gelimorto2/binbot/cad/out/E-01_power.pdf

## BINBOT — autonomous olive bin carrier

## POWER — TOP MODULE FED FROM THE BASE

### DWG E-01 REV C BP-04 electronics

PRELIMINARY — check against vendor datasheets 2026-10-28

BASE — bought, NOT modified (vendor)

base battery
+ BMS

base main
switch

MC-L / MC-R
motor controllers
motors + spring brakes
RC receiver
E-stop / enable input
(all vendor)

aux tap at the base battery (vendor terminal / ring lug) F1 40 A
(at the tap)

S1 key
isolator 50 A

K1 lift contactor
50 A, 24 V coil (E-02)

F4 40 A
U3 DC/DC
36-75 → 24 V 25 A
LIFT

Lift H-bridge K7/K8
(MCU) → actuators
M3, M4 + limits

F5 20 A
AUX 4 mm²

F6 10 A
U1 DC/DC
36-75 → 24 V 10 A
CONTROL

+24 V CTRL → F10…F16: computer, LiDAR, cameras, GNSS, MCU, safety relay, display

F8 5 A
U2 DC/DC
36-75 → 12 V 5 A
COMMS

+12 V → 4G router, LoRa, beacon, buzzer

drive commands (E-03)

E-stop / enable (E-02)

DRIVE INTERFACE — nothing on the base is changed:
- CAN or RS485 to the base controllers, if the base has it; otherwise
- the MCU imitates the RC receiver (PWM / SBUS) through changeover relay K9. The handheld remote always has priority (manual mode).
- The safety relay (E-02) opens the base's own E-stop / enable input.

NOTES
1. Base battery voltage assumed 48 V (check). DC/DCs 36-75 V in; for a 60/72 V base use 40-160 V input types.
2. Our load: ≈ 50-120 W continuous + lift 480 W for ~20 s per swap: small next to the base battery.
3. E-stop: K1 drops (lift stops) and the base's E-stop input opens (motors stop, base brakes clamp).
4. Computer, sensors and radio stay powered after an E-stop so the robot can report.
5. Charging: with the base's own charger and socket (vendor).
