gelimorto2/binbot/cad/out/E-04_ebox_layout.pdf

## E-BOX BACKPLATE 460×460 mm (enclosure 500×500×200 IP65, rear of the top module)

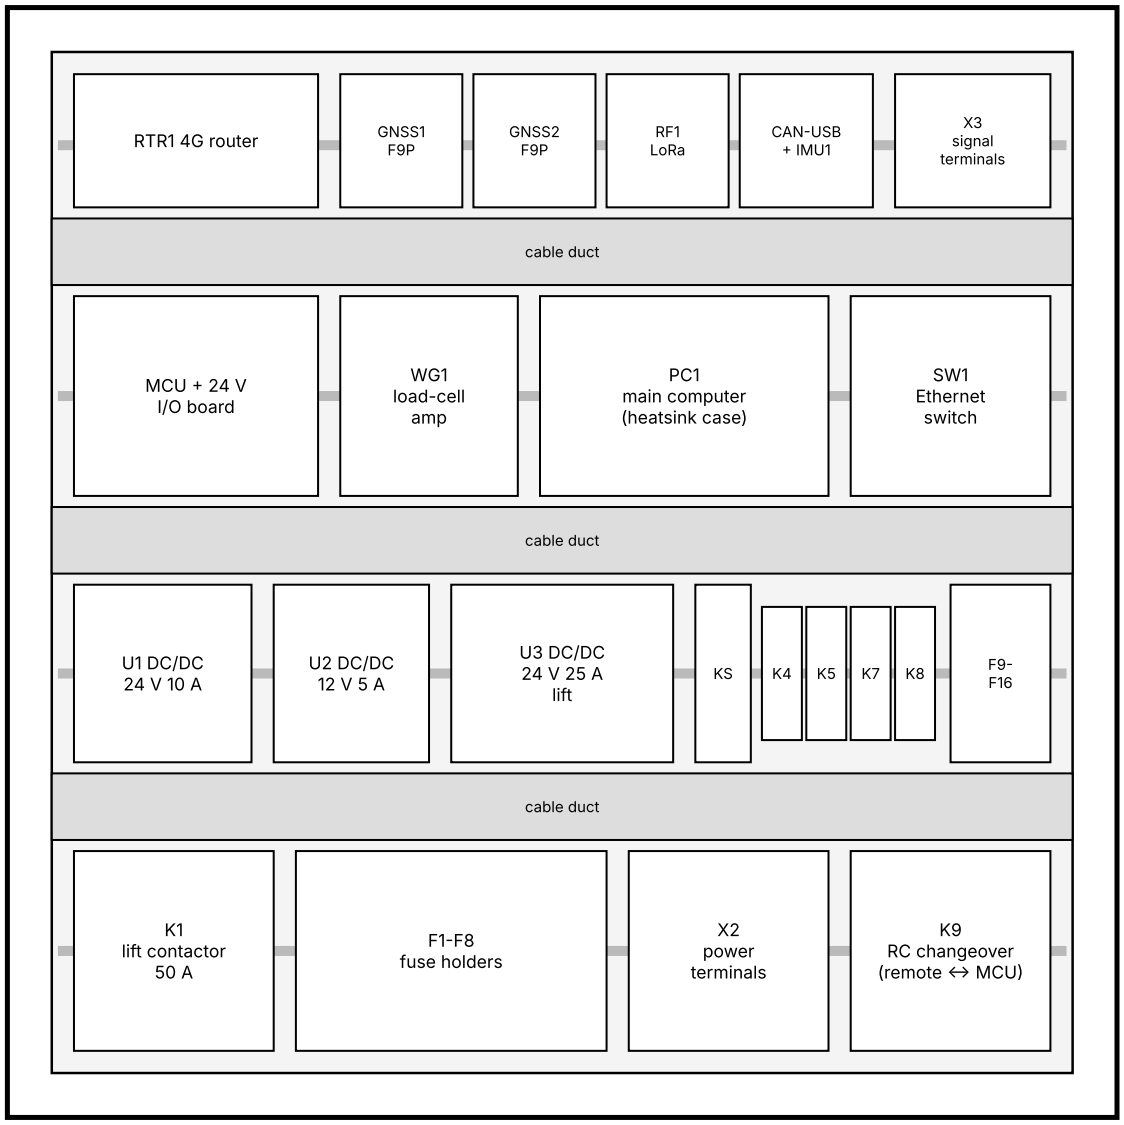
[picture p7: figure]
cable duct; K1 lift contactor 50 A; fuse holders; X2 power terminals; K9 RC changeover (remote ↔ MCU); U3 DC/DC 24 V 25 A lift; MCU + 24 V I/O board; WG1 load-cell amp; PC1 main computer (heatsink case); SW1 Ethernet switch; RTR1 4G router; GNSS1; GNSS2 F9P; RF1 LoRa; CAN-USB; + IMU1; X3 signal terminals

BOTTOM FACE (all cables enter from below, drip loop):

- X10 base drive interface (CAN / RS485 or RC lead) | • X11 base E-stop / enable loop (2 ch)
- X12 power tap from base battery (2 × 6 mm²) | • X13 lift M3/M4 + limits S5/S6
- X14 load cells LC1-LC4 (4× M12) | • X15 front bar: LiDAR, CAM-F, ES1/ES2, edge BF
- X16 rear: ES3/ES4, CAM-R, HMI1, beacon, BR, GNSS1/2 | • nothing goes into the base except X10-X12

RIGHT SIDE: S1 key isolator for the top module
LEFT SIDE: IP65 breather vent + filter fan (thermostat 40 °C) DOOR: nothing mounted (keeps it sealed)

BUILD NOTES
- motor controllers stay in the base (vendor)
- power wiring kept in row A, signals rows C/D
- CAN and Ethernet away from motor cables
- label every wire both ends with its number
- all connectors IP67: Deutsch DT (signals), M12 (sensors/CAN/ETH), Anderson (power)

BINBOT — autonomous olive bin carrier

E-BOX LAYOUT (front view, door open)

DWG E-04 REV C SCALE ≈ 1:4 mm

PRELIMINARY 2026-10-28
