gelimorto2/binbot/cad/out/DWG-001_general_arrangement.png

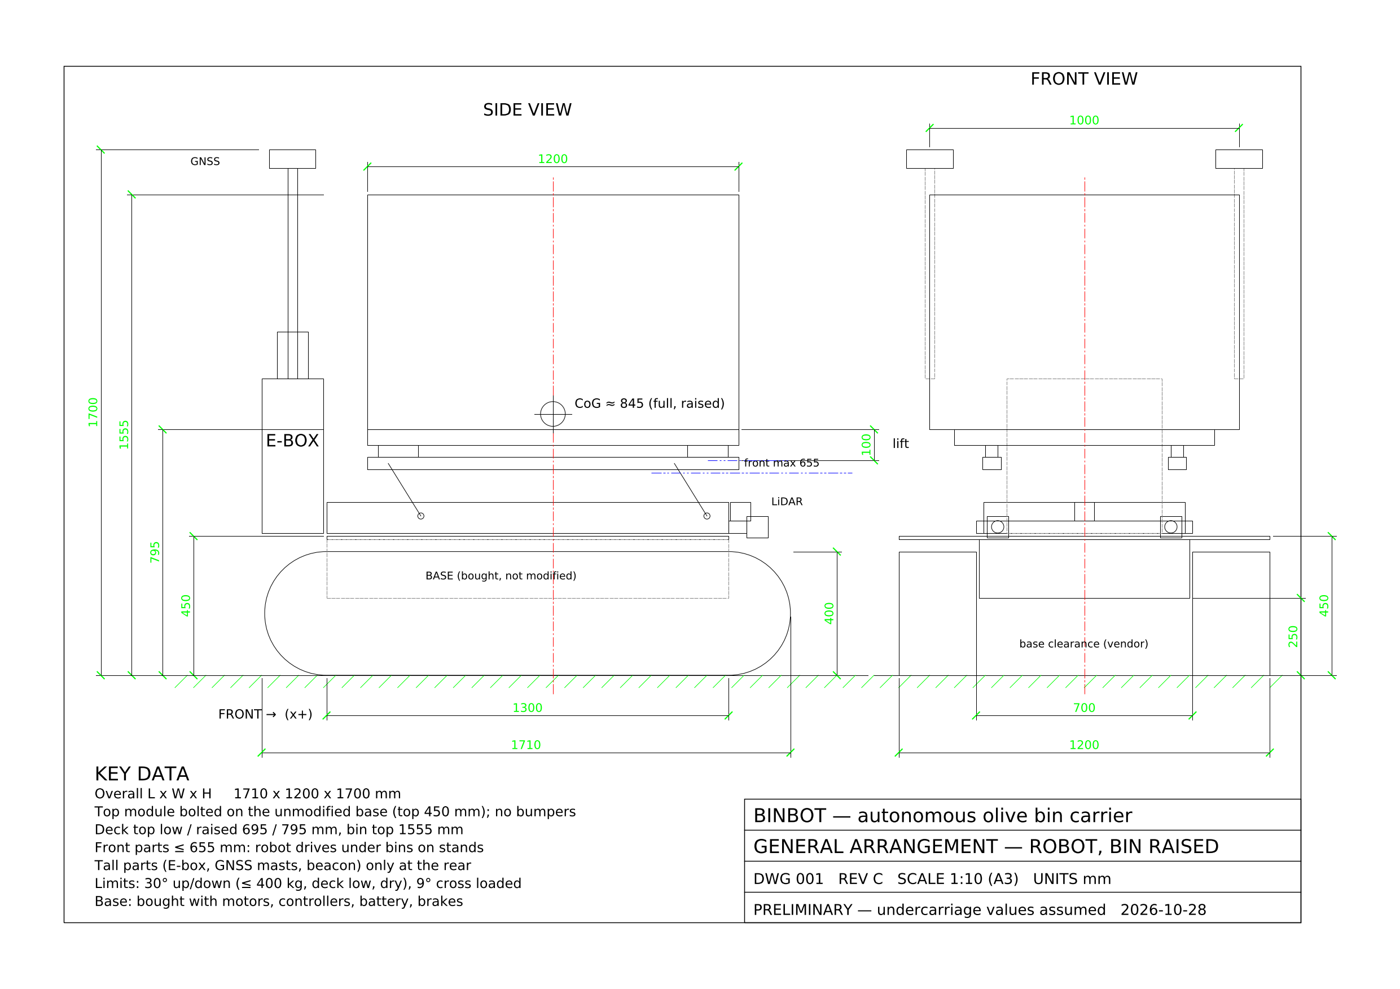
cad/out/DWG-001_general_arrangement.png
