gelimorto2/binbot/cad/out/DWG-002_upper_frame_weldment.png

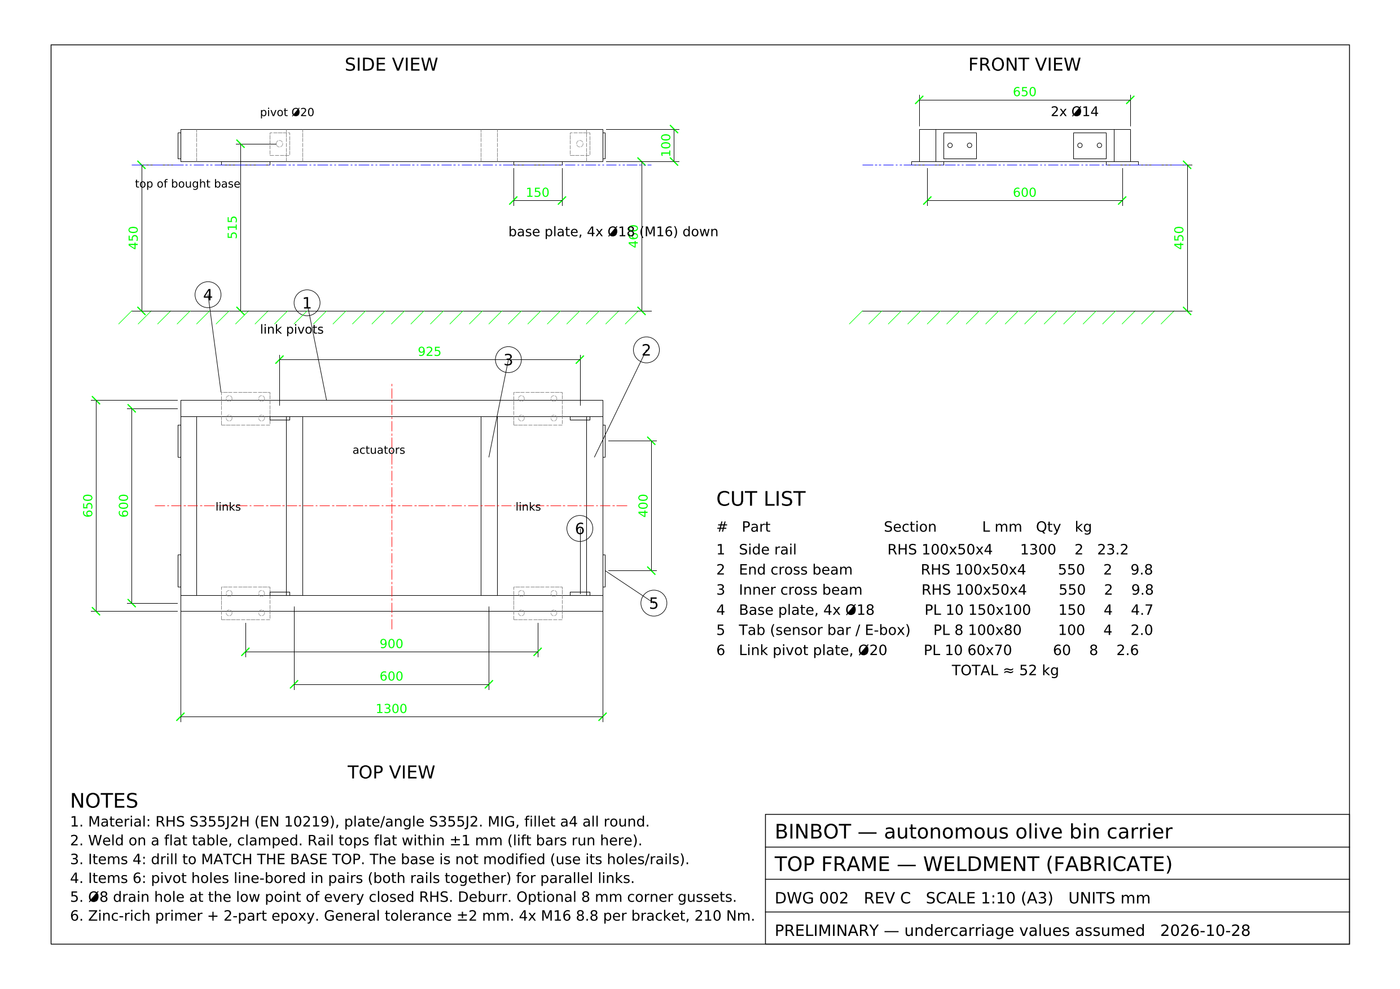
cad/out/DWG-002_upper_frame_weldment.png
