gelimorto2/binbot/cad/out/DWG-003_bin_stand.png

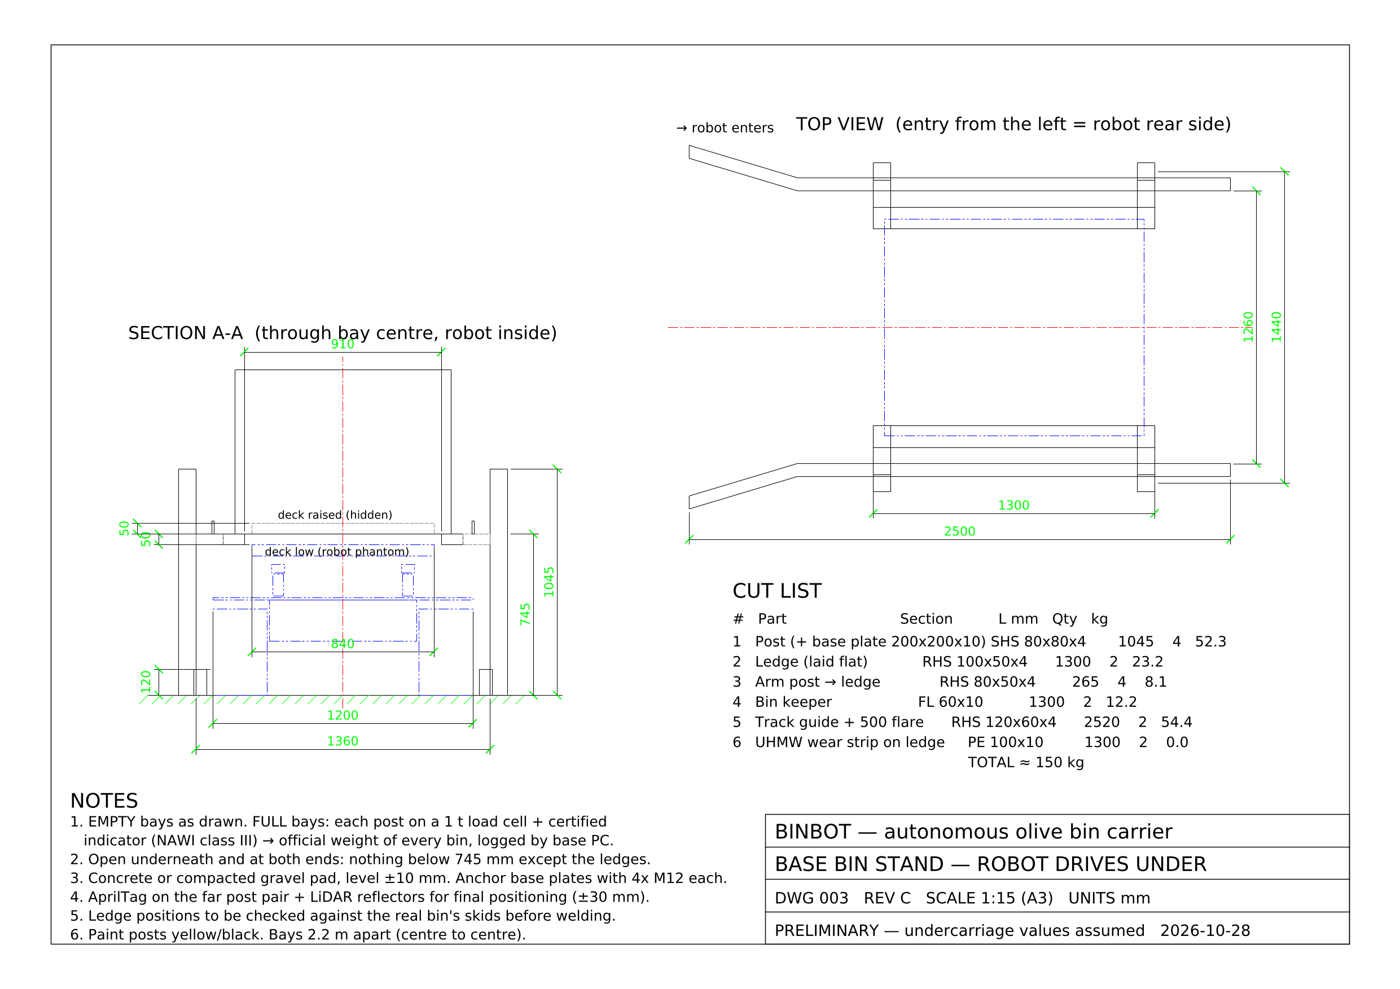
cad/out/DWG-003_bin_stand.png
