gelimorto2/binbot/cad/out/DWG-004_stability.png

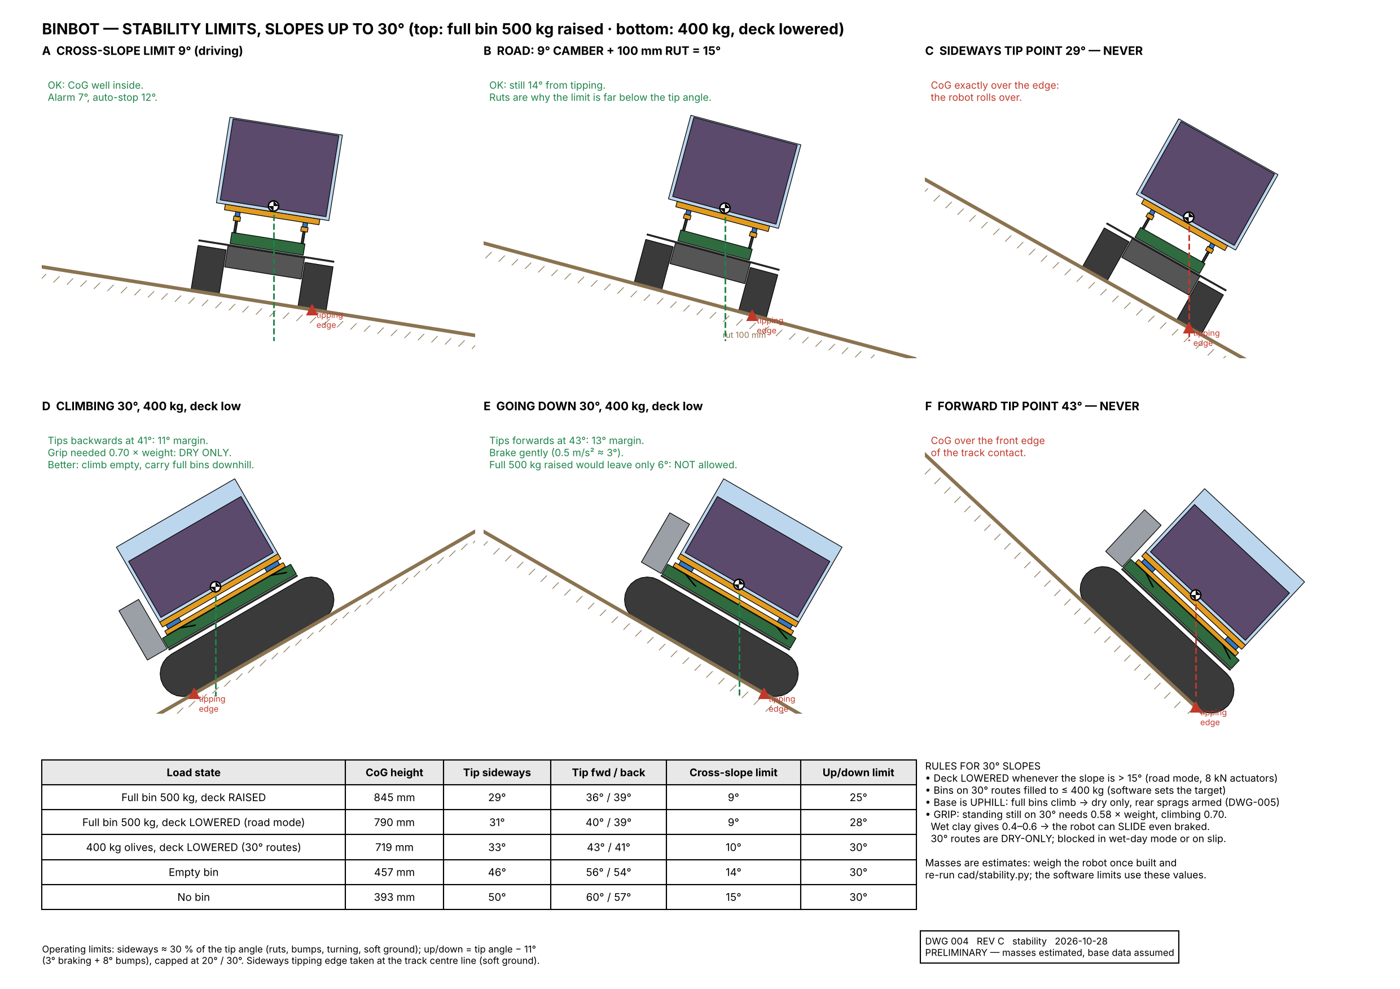
cad/out/DWG-004_stability.png
