gelimorto2/binbot/cad/out/DWG-005_anti_slide.png

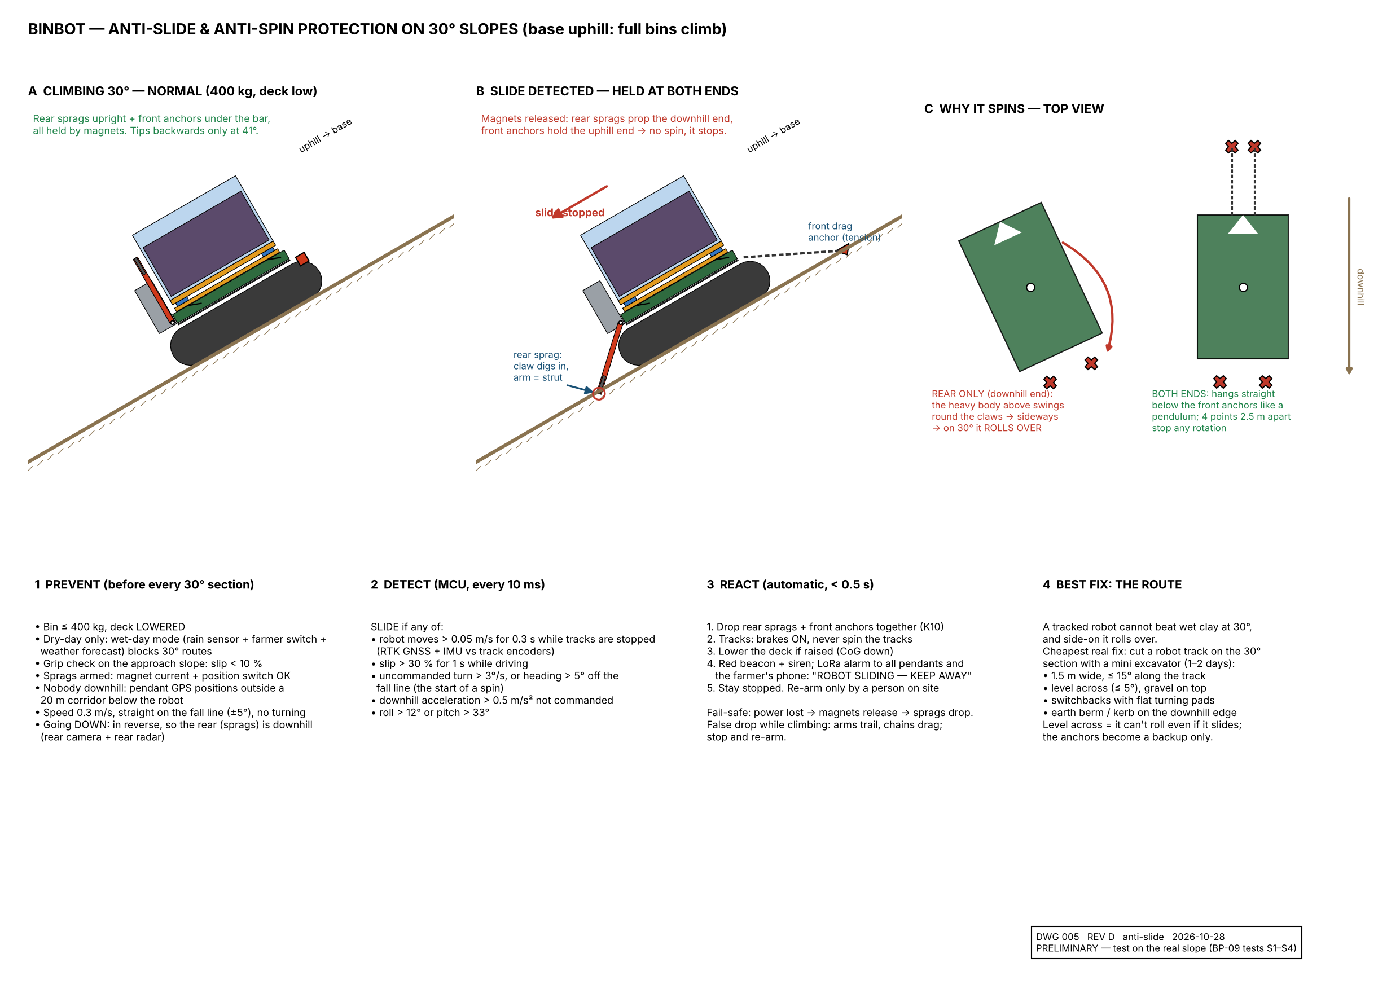
cad/out/DWG-005_anti_slide.png
