gelimorto2/binbot/cad/out/E-01_power.png

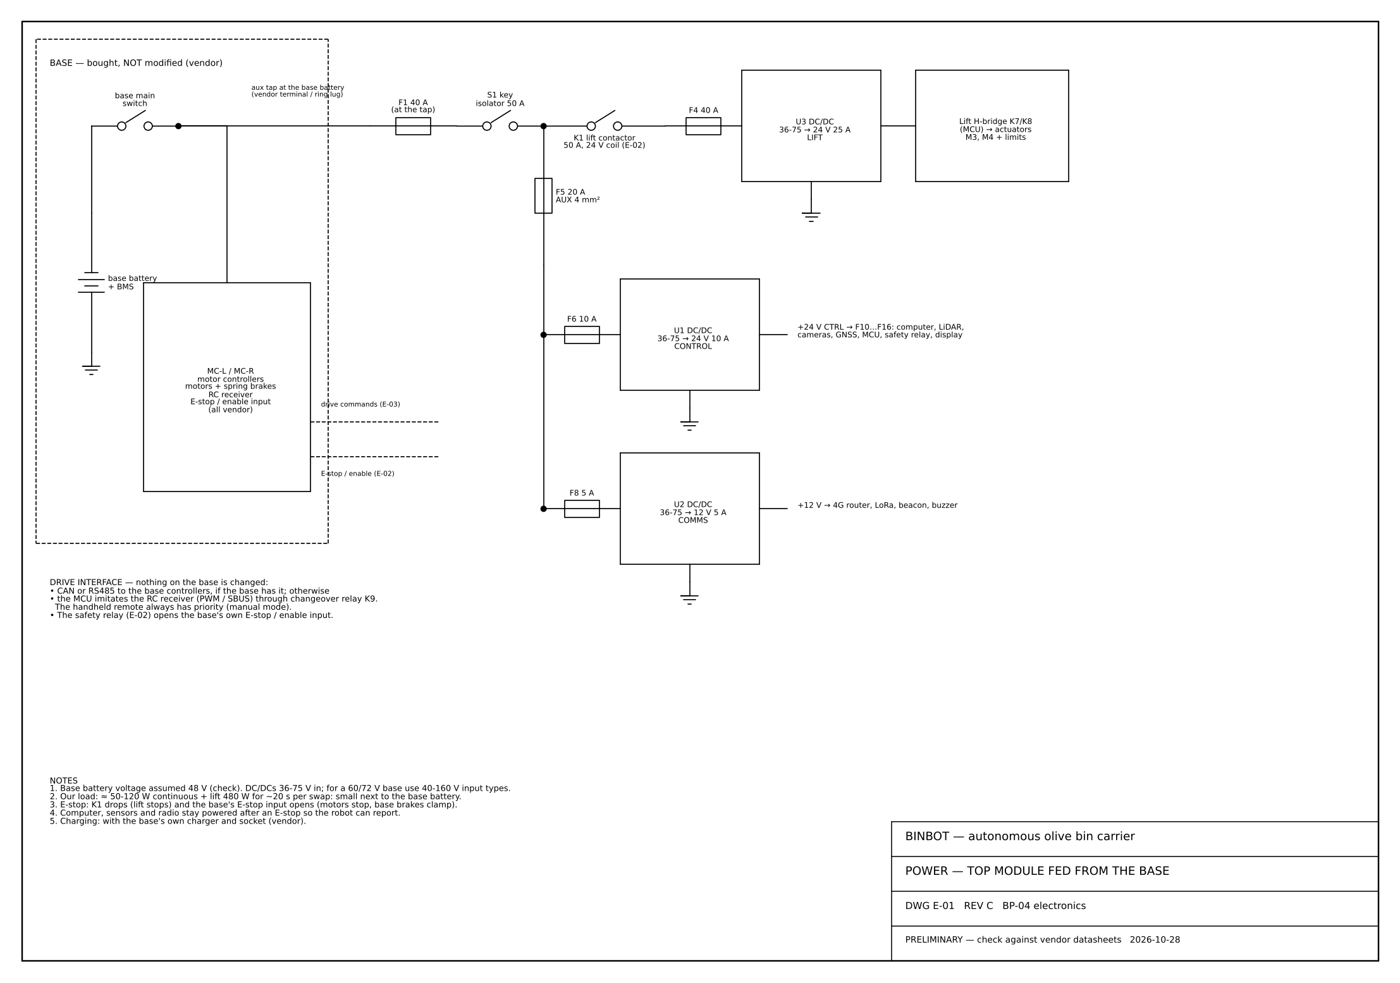
cad/out/E-01_power.png
