gelimorto2/binbot/cad/out/E-02_safety_circuit.png

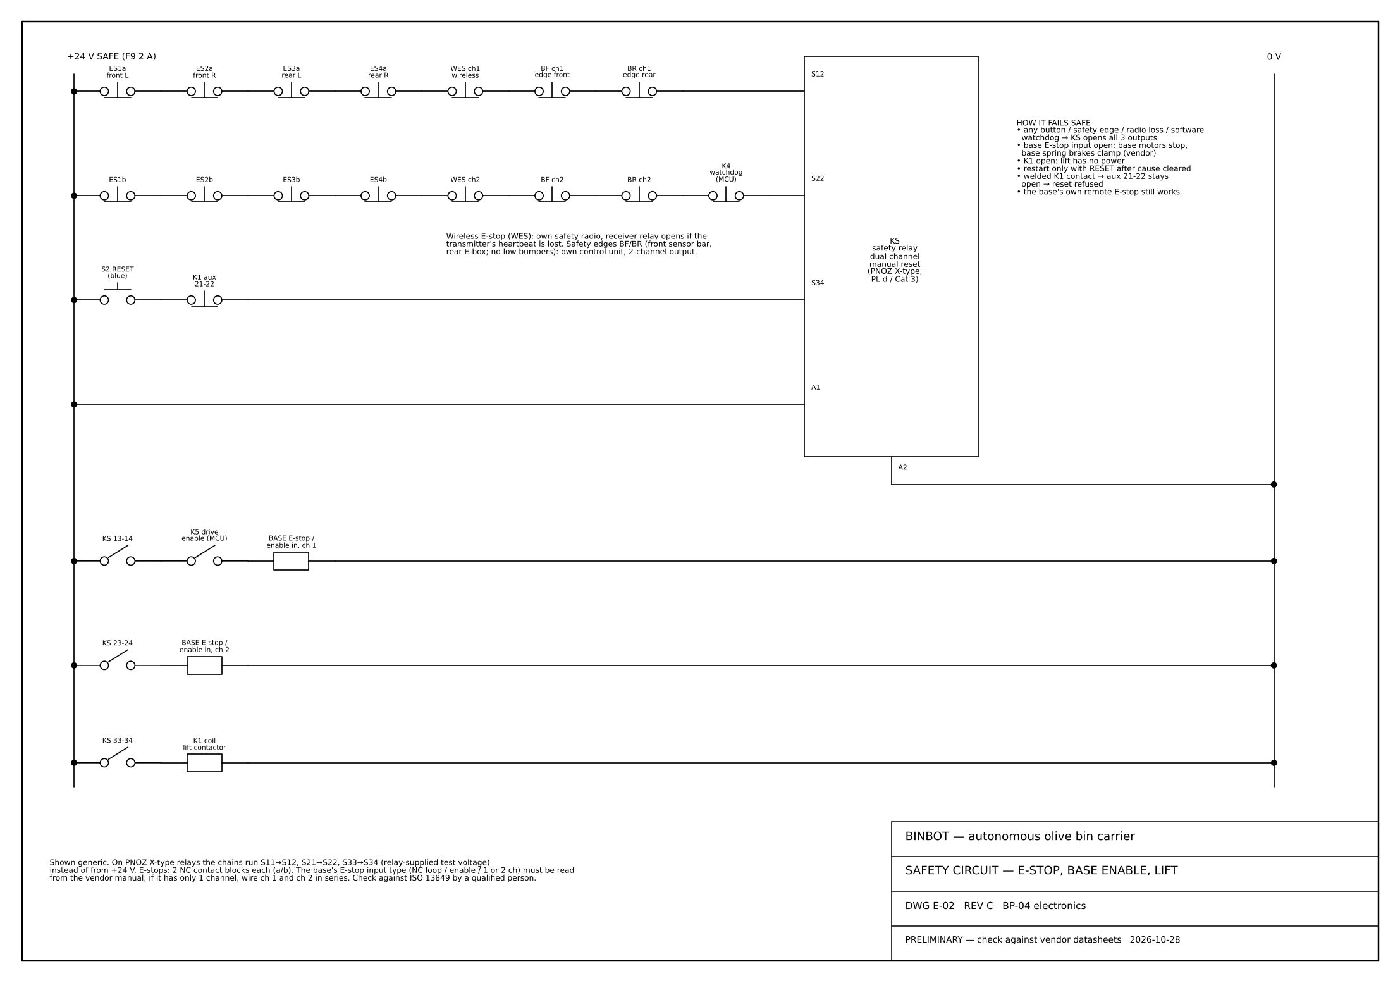
cad/out/E-02_safety_circuit.png
