gelimorto2/binbot/cad/out/E-03_control_block.png

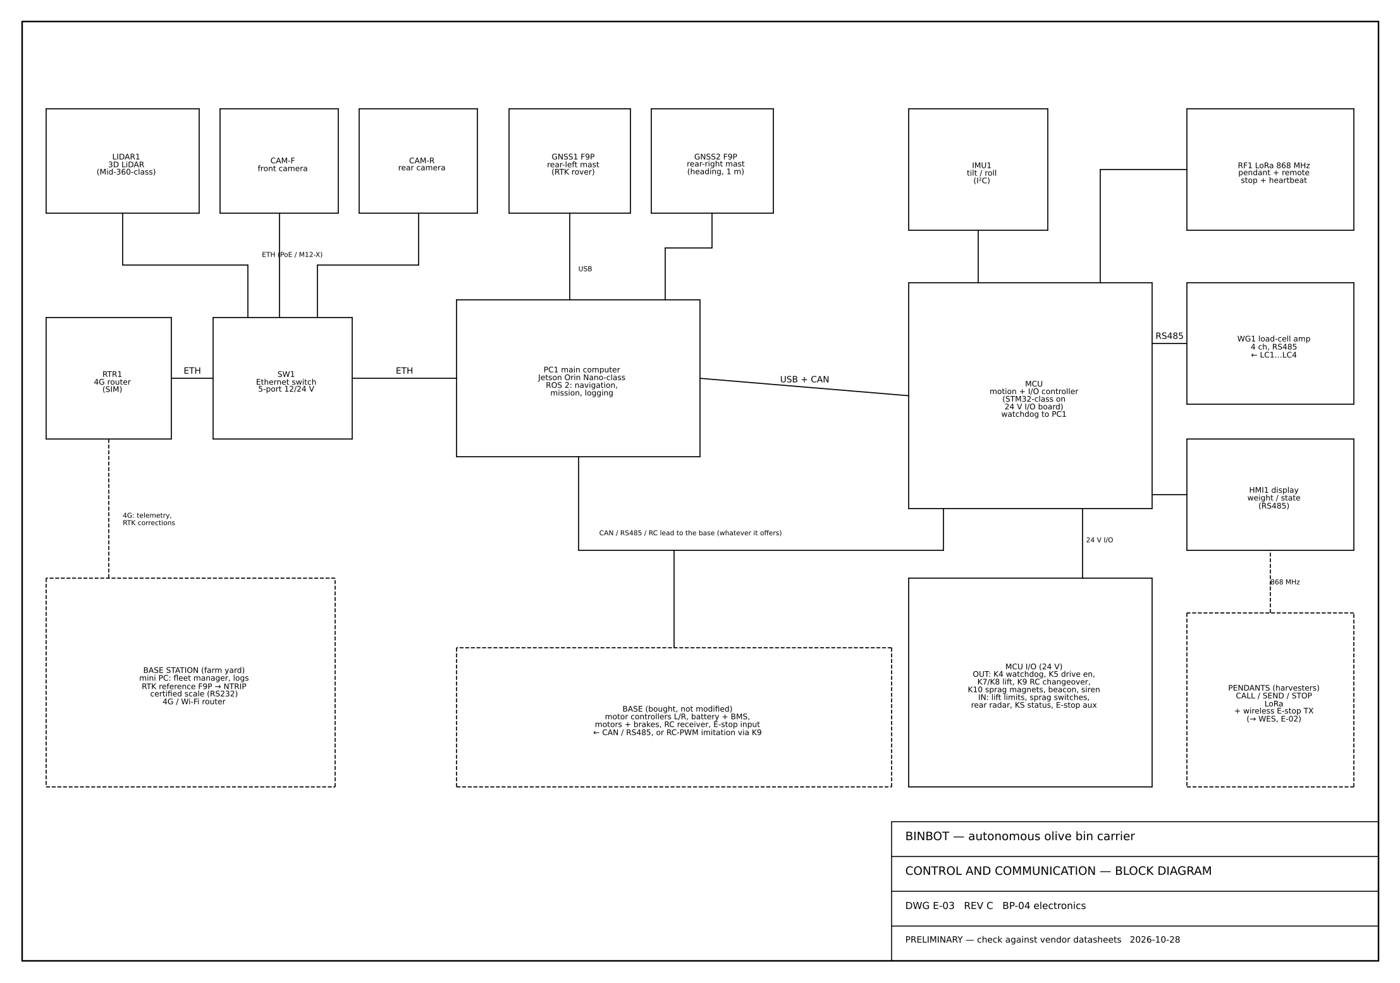
cad/out/E-03_control_block.png
