gelimorto2/binbot/cad/out/E-04_ebox_layout.png

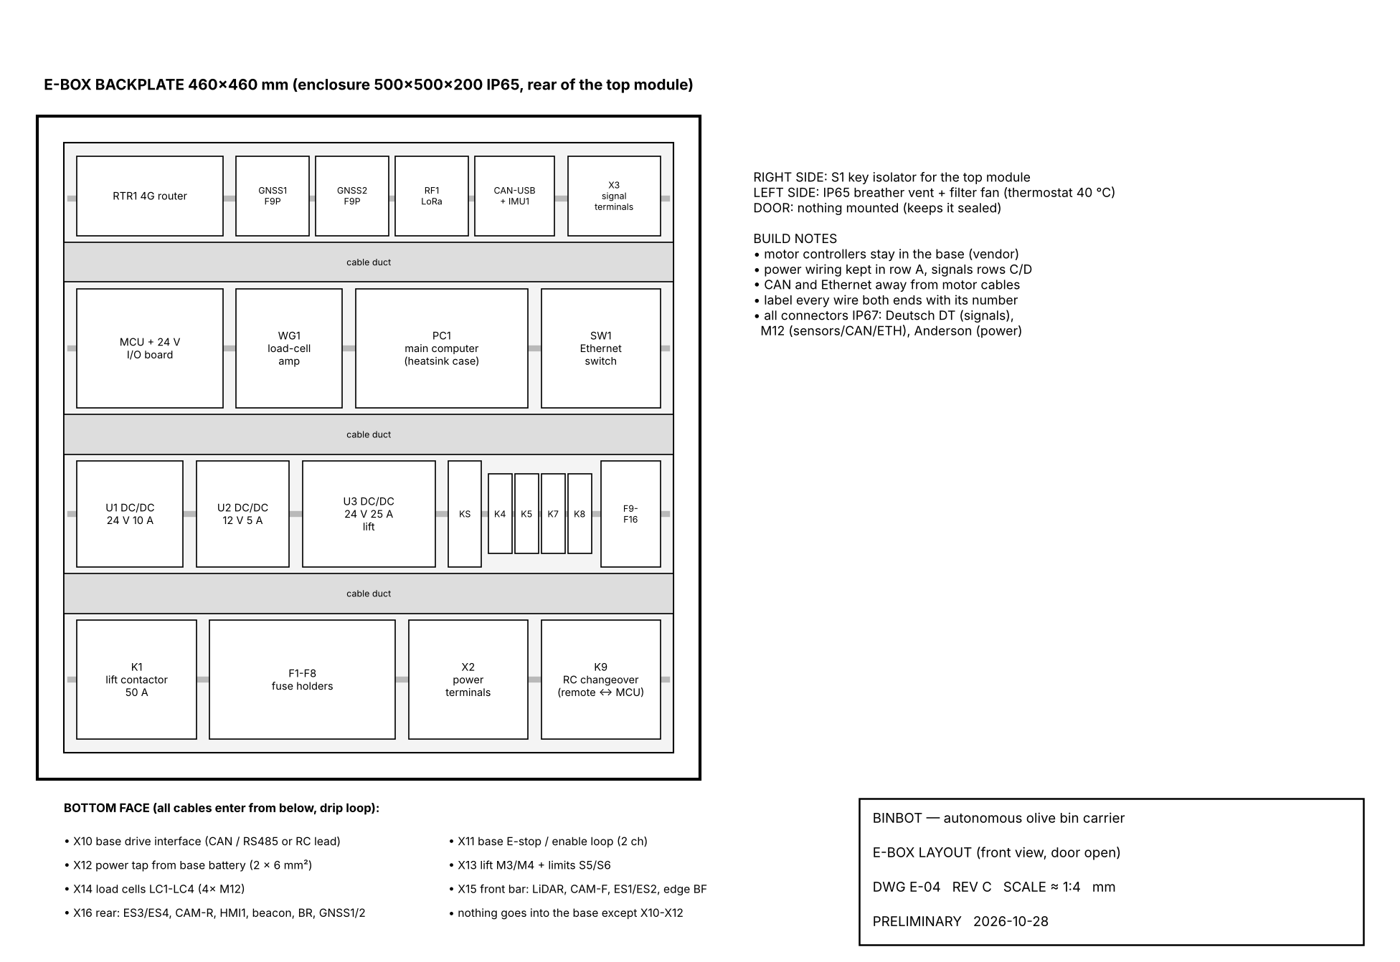
cad/out/E-04_ebox_layout.png
