gelimorto2/binbot/cad/out/chassis_assembly.step

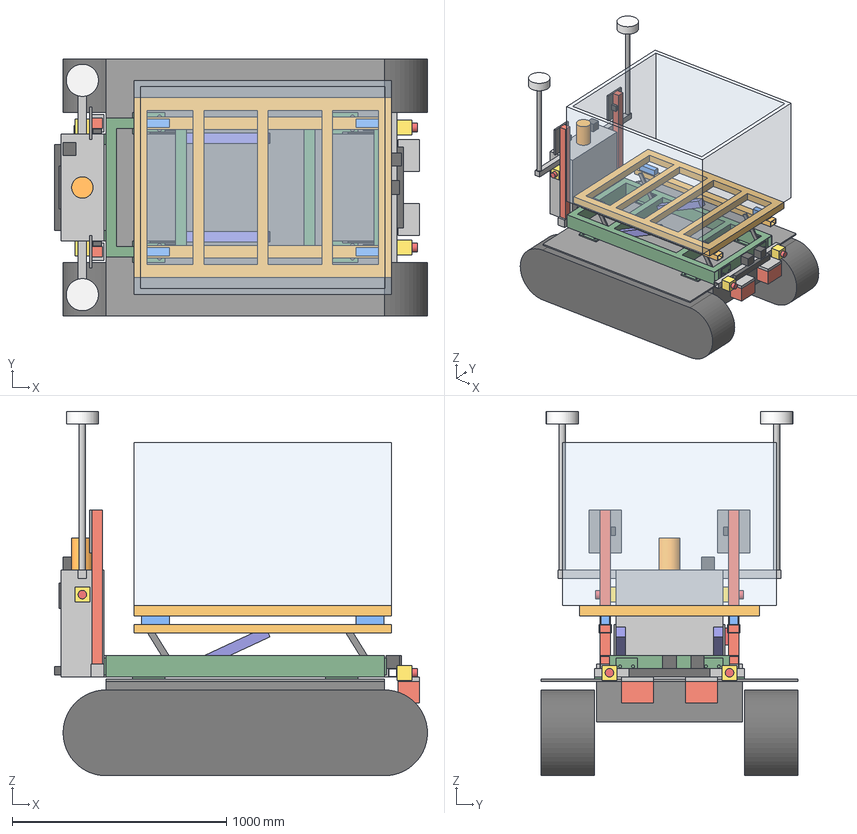
[picture p17: CAD file, 2026-10-28]
cad/out/chassis_assembly.step
1740.0 x 1200.0 x 1700.0 mm
track_L
track_R
base_body
base_top_plate
upper_frame
lift_bar_0
link_1
link_2
lift_actuator_3
load_cell_4
load_cell_5
lift_bar_6
link_7
link_8
lift_actuator_9
load_cell_10
load_cell_11
deck_12
ebox_13
ebox_mount_14
display_15
isolator_S1_16
safety_edge_rear_17
estop_rear_18
estop_rear_knob_19
mast_arm_20
mast_21
gnss_antenna_22
estop_rear_23
estop_rear_knob_24
mast_arm_25
mast_26
gnss_antenna_27
beacon_28
sprag_arm_29
sprag_claw_30
sprag_pivot_31
sprag_magnet_32
sprag_arm_33
sprag_claw_34
sprag_pivot_35
sprag_magnet_36
cam_rear_37
front_bar_38
front_bar_arm_39
estop_front_40
estop_front_knob_41
front_bar_arm_42
estop_front_43
estop_front_knob_44
lidar_45
drag_anchor_46
anchor_holder_47
drag_anchor_48
anchor_holder_49
cam_front_50
safety_edge_front_51
bin
