gelimorto2/binbot/cad/out/upper_frame.step

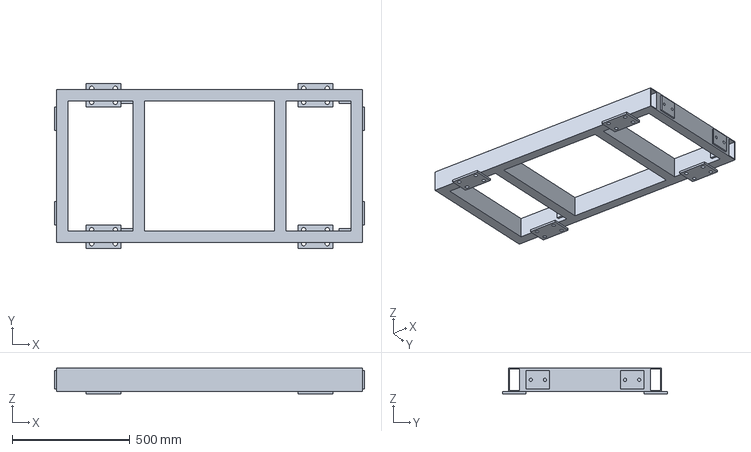
[picture p18: CAD file, 2026-10-28]
cad/out/upper_frame.step
1316.0 x 700.0 x 110.0 mm
