gelimorto2/binbot/cad/out/bin_stand.step

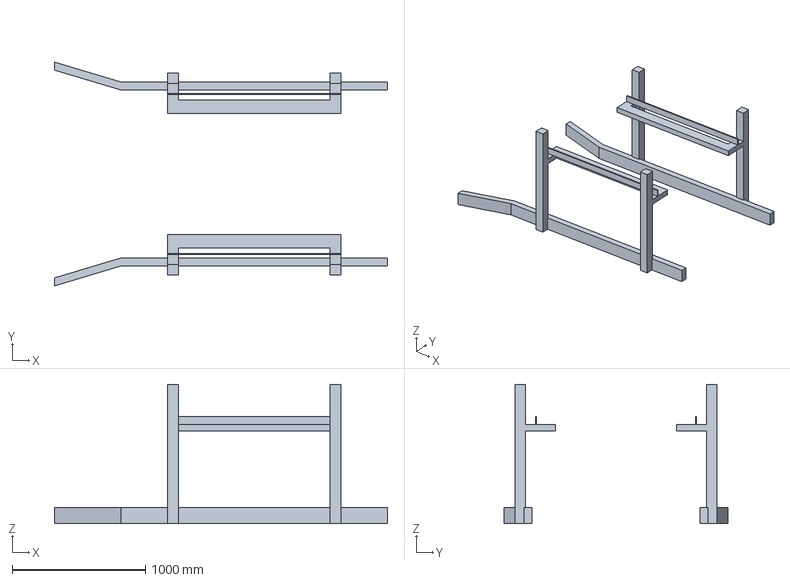
[picture p19: CAD file, 2026-10-28]
cad/out/bin_stand.step
2500.0 x 1680.0 x 1045.0 mm
