gelimorto2/binbot/cad/out/DWG-002_upper_frame_weldment.dxf

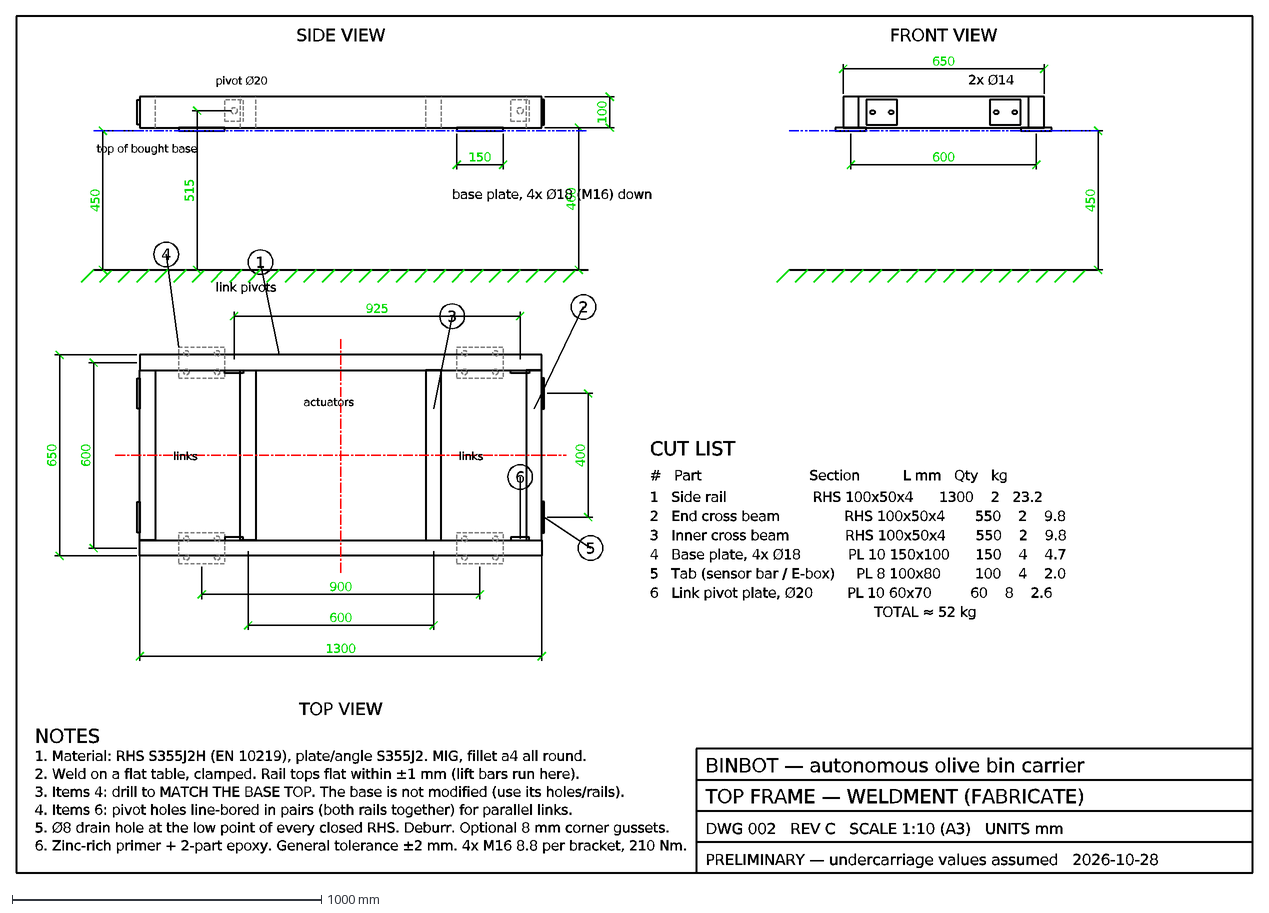
[picture p21: CAD file, 2026-10-28]
cad/out/DWG-002_upper_frame_weldment.dxf
BINBOT — autonomous olive bin carrier
TOP FRAME — WELDMENT (FABRICATE)
DWG 002 REV C SCALE 1:10 (A3) UNITS mm
PRELIMINARY — undercarriage values assumed 2026-10-28
TOP VIEW
1300
900
600
925
650
400
link pivots
1
2
3
4
5
6
links
actuators
SIDE VIEW
460
100
150
450
515
base plate, 4x Ø18 (M16) down
top of bought base
pivot Ø20
FRONT VIEW
2x Ø14
CUT LIST
# Part Section L mm Qty kg
1 Side rail RHS 100x50x4 1300 2 23.2
2 End cross beam RHS 100x50x4 550 2 9.8
3 Inner cross beam RHS 100x50x4 550 2 9.8
4 Base plate, 4x Ø18 PL 10 150x100 150 4 4.7
5 Tab (sensor bar / E-box) PL 8 100x80 100 4 2.0
6 Link pivot plate, Ø20 PL 10 60x70 60 8 2.6
TOTAL ≈ 52 kg
NOTES
1. Material: RHS S355J2H (EN 10219), plate/angle S355J2. MIG, fillet a4 all round.
2. Weld on a flat table, clamped. Rail tops flat within ±1 mm (lift bars run here).
3. Items 4: drill to MATCH THE BASE TOP. The base is not modified (use its holes/rails).
4. Items 6: pivot holes line-bored in pairs (both rails together) for parallel links.
5. Ø8 drain hole at the low point of every closed RHS. Deburr. Optional 8 mm corner gussets.
6. Zinc-rich primer + 2-part epoxy. General tolerance ±2 mm. 4x M16 8.8 per bracket, 210 Nm.
