gelimorto2/binbot/cad/out/DWG-003_bin_stand.dxf

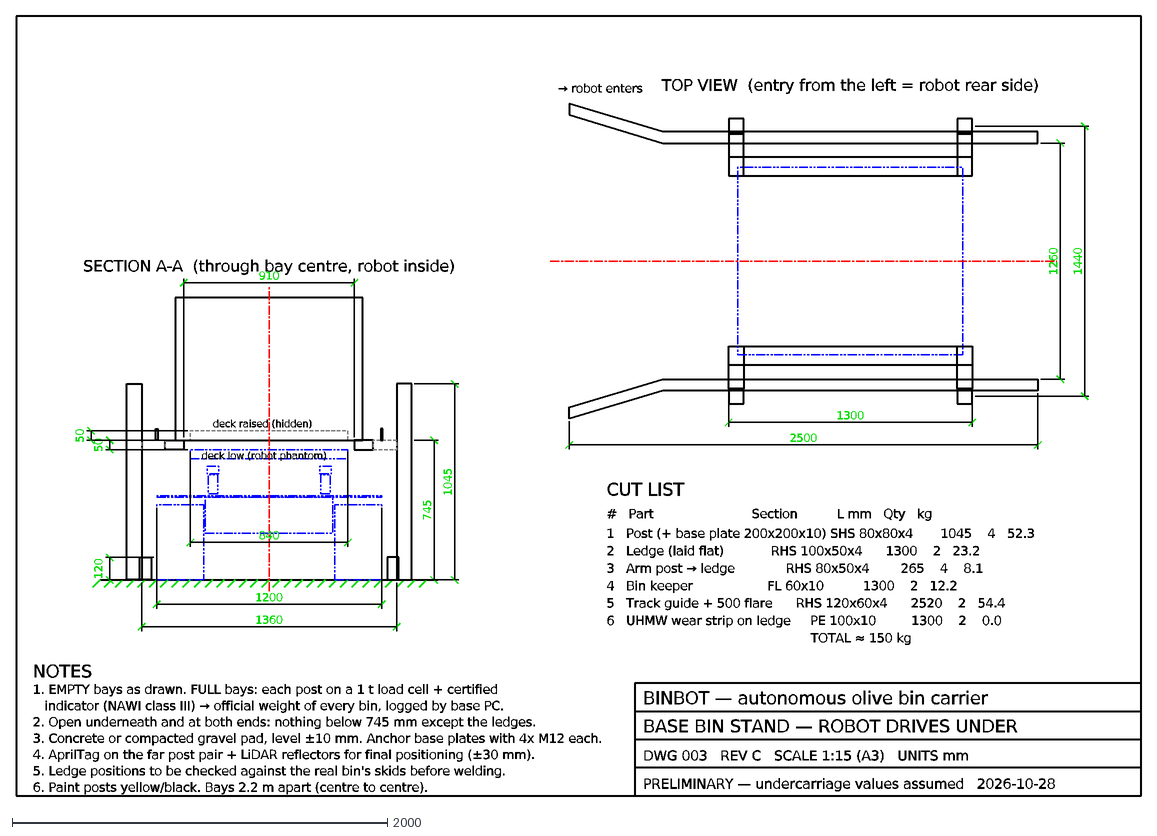
[picture p22: CAD file, 2026-10-28]
cad/out/DWG-003_bin_stand.dxf
BINBOT — autonomous olive bin carrier
BASE BIN STAND — ROBOT DRIVES UNDER
DWG 003 REV C SCALE 1:15 (A3) UNITS mm
PRELIMINARY — undercarriage values assumed 2026-10-28
SECTION A-A (through bay centre, robot inside)
deck low (robot phantom)
deck raised (hidden)
1360
1200
910
840
745
1045
50
120
TOP VIEW (entry from the left = robot rear side)
1300
2500
1260
1440
→ robot enters
CUT LIST
# Part Section L mm Qty kg
1 Post (+ base plate 200x200x10) SHS 80x80x4 1045 4 52.3
2 Ledge (laid flat) RHS 100x50x4 1300 2 23.2
3 Arm post → ledge RHS 80x50x4 265 4 8.1
4 Bin keeper FL 60x10 1300 2 12.2
5 Track guide + 500 flare RHS 120x60x4 2520 2 54.4
6 UHMW wear strip on ledge PE 100x10 1300 2 0.0
TOTAL ≈ 150 kg
NOTES
1. EMPTY bays as drawn. FULL bays: each post on a 1 t load cell + certified
indicator (NAWI class III) → official weight of every bin, logged by base PC.
2. Open underneath and at both ends: nothing below 745 mm except the ledges.
3. Concrete or compacted gravel pad, level ±10 mm. Anchor base plates with 4x M12 each.
4. AprilTag on the far post pair + LiDAR reflectors for final positioning (±30 mm).
5. Ledge positions to be checked against the real bin's skids before welding.
6. Paint posts yellow/black. Bays 2.2 m apart (centre to centre).
