gelimorto2/binbot/cad/out/DWG-001_general_arrangement.dxf

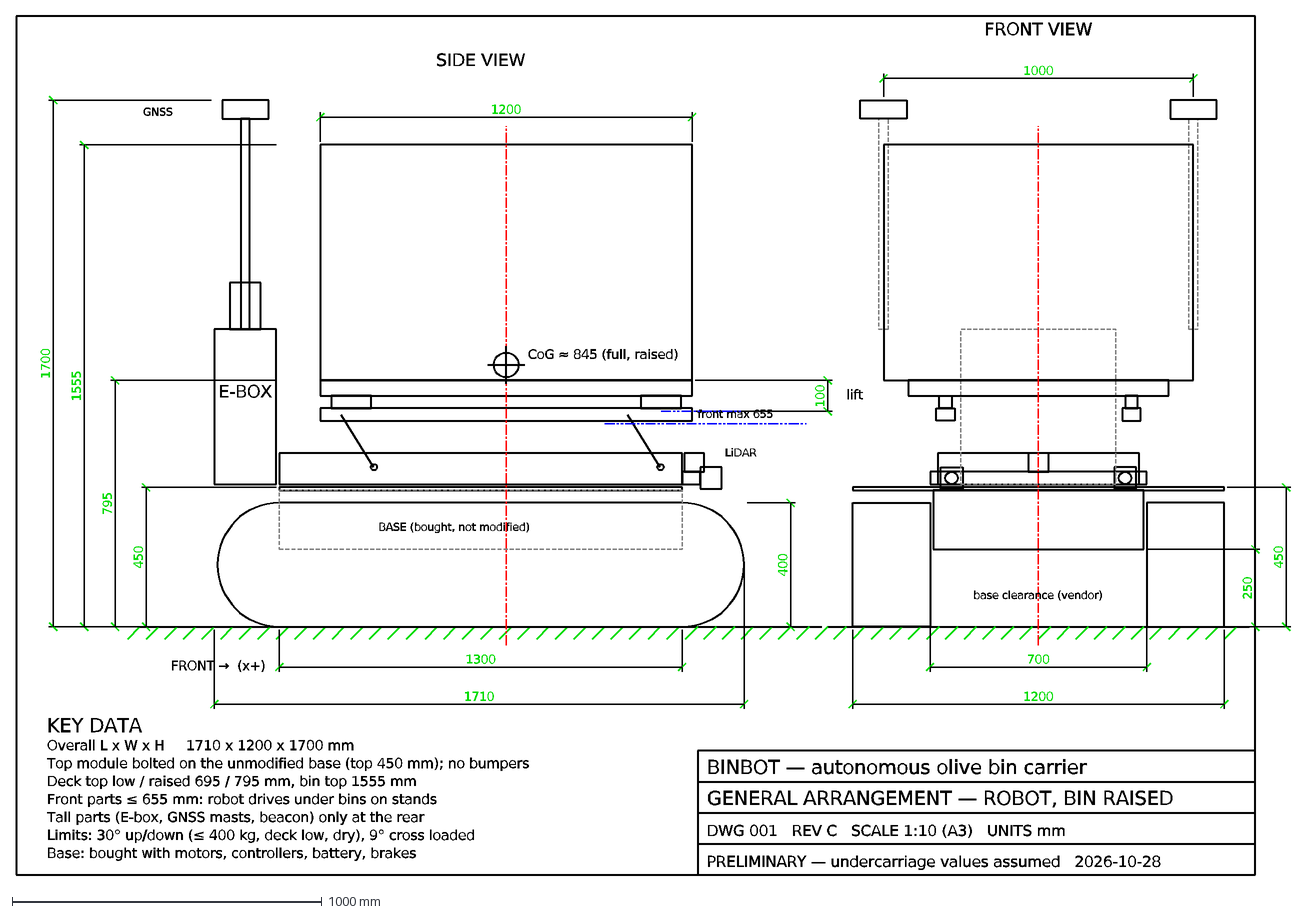
[picture p23: CAD file, 2026-10-28]
cad/out/DWG-001_general_arrangement.dxf
BINBOT — autonomous olive bin carrier
GENERAL ARRANGEMENT — ROBOT, BIN RAISED
DWG 001 REV C SCALE 1:10 (A3) UNITS mm
PRELIMINARY — undercarriage values assumed 2026-10-28
SIDE VIEW
BASE (bought, not modified)
E-BOX
front max 655
CoG ≈ 845 (full, raised)
GNSS
LiDAR
FRONT → (x+)
1300
1710
1200
450
795
1555
1700
400
100
lift
FRONT VIEW
700
1000
250
base clearance (vendor)
KEY DATA
Overall L x W x H 1710 x 1200 x 1700 mm
Top module bolted on the unmodified base (top 450 mm); no bumpers
Deck top low / raised 695 / 795 mm, bin top 1555 mm
Front parts ≤ 655 mm: robot drives under bins on stands
Tall parts (E-box, GNSS masts, beacon) only at the rear
Limits: 30° up/down (≤ 400 kg, deck low, dry), 9° cross loaded
Base: bought with motors, controllers, battery, brakes
