gelimorto2/binbot/(list of files, cad)

Other CAD files:
cad/out/bin_stand.stl
cad/out/chassis_assembly.stl
cad/out/upper_frame.stl
