gelimorto2/binbot/docs/bp-04-electronics-wiring.md

# BP‑04 — Electronics & Wiring (v0.2)

Part of the [BinBot wireframe](00-wireframe.md). **Rev C: the bought base keeps
its own battery, motor controllers, brakes and remote, untouched.** This covers only
the top module's electronics and its three connections to the base. Covers power distribution,
the safety circuit, control and communications, the electronics box (E‑box),
fuses, wires and connectors. The sensors themselves (LiDAR, GNSS, cameras)
are detailed in BP‑05; here they are wired in.

## 1. Drawings

| DWG | Title | Files |
|---|---|---|
| E‑01 | Power distribution 48 V | [PDF](../cad/out/E-01_power.pdf) · [PNG](../cad/out/E-01_power.png) |
| E‑02 | Safety circuit: E‑stops, contactor, brakes | [PDF](../cad/out/E-02_safety_circuit.pdf) · [PNG](../cad/out/E-02_safety_circuit.png) |
| E‑03 | Control & communication block diagram | [PDF](../cad/out/E-03_control_block.pdf) · [PNG](../cad/out/E-03_control_block.png) |
| E‑04 | E‑box layout (backplate) | [PDF](../cad/out/E-04_ebox_layout.pdf) · [PNG](../cad/out/E-04_ebox_layout.png) |
| 001 | General arrangement incl. E‑box, low front sensor bar, rear masts | [PDF](../cad/out/DWG-001_general_arrangement.pdf) |
| 3D | All components placed on the chassis | [STL](../cad/out/chassis_assembly.stl) · [STEP](../cad/out/chassis_assembly.step) |

Generated by `cad/electrical.py`, `cad/drawings.py` and `cad/model.py`.

## 2. Where everything sits

| Location | Components |
|---|---|
| **Inside the bought base** (vendor, unchanged) | Battery + BMS, main switch, motor controllers, motors + brakes, RC receiver, charger socket |
| **E‑box** (rear, 500×500×200 IP65) | Fuse at the tap, key isolator, lift contactor, DC/DCs, safety relay, relays, RC changeover, MCU, computer, Ethernet switch, 4G router, GNSS boards, LoRa, load‑cell amp |
| E‑box rear face | HMI1 display, rear safety edge (BR), rear camera on top, beacon on top |
| E‑box sides | ES3/ES4 E‑stops, S1 key isolator |
| Rear outriggers | GNSS1 / GNSS2 antenna masts at the rear corners, 1 m apart across, 1.7 m high |
| **Low front sensor bar** (≤ 655 mm, passes under bins) | LiDAR, front camera, ES1/ES2 E‑stops, front safety edge (BF) |
| Top frame | 4 load cells, 2 lift actuators + limit switches, 4 links (BP‑02) |
| Rear | 2 anti‑slide sprags with holding magnets (relay K10) and position switches, rear radar ([BP‑09a](bp-09-safety-slopes.md)) |

No bumpers (rocks). Nothing at the front is taller than 655 mm, because the
front drives under bins on the base stands (BP‑02).

GNSS1 and GNSS2 are 1 m apart across the robot, which gives the heading.

## 3. How it works

- **Power (E‑01):** a fused tap (F1 40 A) at the base battery → key isolator →
  aux supplies (computer, sensors, radio) and, through **lift contactor K1**, the
  lift. Aux stays on after an E‑stop so the robot can report.
- **Driving:** the MCU commands the base's own controllers by CAN or RS485 if
  they have it; otherwise it imitates the RC receiver (PWM/SBUS) through
  changeover relay K9. The handheld remote always wins (manual mode).
- **Safety (E‑02):** 4 E‑stops, wireless E‑stop, both safety edges and the software
  watchdog are wired in **two channels** into a safety relay. Any one of them opens
  the base's **E‑stop/enable input** (base motors stop, its spring brakes clamp)
  and K1 (no lift).
  Restart needs the blue RESET button. A welded contactor blocks the reset.
- **Control (E‑03):** the computer plans and drives; the MCU does real‑time
  I/O (base drive commands, lift, weighing, display, LoRa pendant, watchdog).
  If the computer hangs, the MCU stops the robot. If the MCU hangs, its watchdog
  relay K4 opens the safety chain.

## 4. Power budget

| Rail | Loads | Typical | Peak | Supply |
|---|---|---|---|---|
| Base drive | motors, controllers (vendor) | — | — | base battery, unchanged |
| 24 V LIFT | 2 actuators | 0 | 480 W, ~20 s per swap | U3 600 W |
| 24 V CTRL | PC1 15, LiDAR 7, cameras 6, GNSS 2, MCU+relays 10, display 5, switch 4 | 50 W | 80 W | U1 240 W |
| 12 V COMMS | router 6, LoRa 1, beacon 8, buzzer 2 | 10 W | 17 W | U2 60 W |

A full day ≈ 0.5–0.7 kWh from the base battery, small next to the drive.
**DC/DC input range must match the base battery** (36–75 V for a 48 V base;
40–160 V types for 60/72 V).

## 5. Fuses and wires

| Ref | Circuit | Fuse | Wire |
|---|---|---|---|
| F1 | Tap at the base battery (as close to it as possible) | 40 A | 6 mm² |
| F4 | Lift DC/DC U3 | 40 A | 6 mm² |
| F5 | Aux (U1 + U2) | 20 A | 4 mm² |
| F6 | U1 24 V CTRL input | 10 A | 2.5 mm² |
| F8 | U2 12 V input | 5 A | 1.5 mm² |
| F9 | 24 V SAFE (safety relay + chains) | 2 A | 1 mm² |
| F10–F16 | 24 V branches: PC1 3 A, LiDAR 1 A, cameras 1 A, MCU 2 A, brakes 4 A, display 1 A, switch 1 A | as listed | 0.75–1 mm² |
| — | CAN / RS485 to the base | — | twisted pair 120 Ω, terminated per the base manual |

Wire: tinned, flexible, 105 °C (e.g. H07RN‑F / automotive FLRY). Every wire
numbered at both ends. Power cables tied every 200 mm, protected where they pass steel.

## 6. Connectors (E‑box bottom face)

| Ref | To | Type |
|---|---|---|
| X10 | Base drive interface: CAN / RS485, or RC receiver lead via K9 | M12 A‑coded / as the base's connector |
| X11 | Base E‑stop / enable input (1 or 2 channels) | Deutsch DT 4‑pin |
| X12 | Power tap from the base battery | Anderson SB50, 6 mm² |
| X13 | Lift actuators M3/M4 + limits S5/S6 | Deutsch DT 6‑pin ×2 |
| X14 | Load cells LC1–LC4 | M12 A‑coded 4‑pin ×4 |
| X15 | Front sensor bar: LiDAR (ETH + 24 V), CAM‑F, ES1/ES2, edge BF | M12 X‑coded ETH, M12 8‑pin |
| X16 | Rear: ES3/ES4, CAM‑R, HMI1, beacon, BR, GNSS1/GNSS2 coax | M12 8‑pin, TNC bulkhead |

Only X10–X12 go to the base, and all three plug into what the base already has.
All cables enter from below with a drip loop. Nothing on the door.

## 7. Parts list and cost (estimates)

Battery, computer, LiDAR, cameras and GNSS are in other budget lines (§11 of the
wireframe). Prices are typical and need checking.

| Group | Items | Est. € |
|---|---|---|
| **A. Power distribution** | F1 40 A at the tap + holder, S1 key isolator 50 A, K1 lift contactor 50 A (24 V coil), fuses F4–F16 + holders, U1 240 W, U2 60 W, U3 600 W DC/DCs, K9 RC changeover, terminals, cable | 300–480 |
| **B. Safety** | KS safety relay (dual channel, manual reset), 4 × E‑stop in IP67 housing (2 NC each), wireless E‑stop TX/RX (dual channel), 2 safety edges + control unit, K4, K5, K7, K8 interface relays, S2 reset | 820–1,300 |
| **C. Control & comms** | MCU + 24 V I/O board, WG1 4‑ch load‑cell amp RS485, IMU1, CAN‑USB, HMI1 display in IP65 window, beacon + buzzer, SW1 Ethernet switch, RTR1 4G router, RF1 LoRa + 2 pendants | 510–930 |
| **D. Enclosure & wiring** | E‑box 500×500×200 IP65 + backplate, DIN rails, ducts, terminals, Deutsch/M12 connectors, glands, signal/CAN/Ethernet cable, breather + fan | 430–650 |
| **Total BP‑04** | | **≈ 2,000–3,350** |

Battery, charger and motor controllers: in the base (check what the €1,200 includes).

Ways to save:
- Arduino Opta / small PLC as MCU + I/O (fewer parts to wire): about the same cost, less work
- Cheaper 4G router (consumer, in the E‑box): –€50–100
- DIY LoRa pendants: –€40

## 8. Tests before first drive

| # | Test | Pass |
|---|---|---|
| E1 | Insulation of our module: tap + and − to the top frame, isolator open | > 1 MΩ |
| E2 | Drive interface: MCU commands slow forward / reverse / turn, base on stands | Matches the remote; remote overrides |
| E3 | Each E‑stop, the wireless E‑stop, each safety edge, watchdog: trigger **one at a time** while the tracks run on stands | Base stops, its brakes clamp, K1 drops, reset needed |
| E4 | Wireless E‑stop out of range / battery removed | Robot stops within 0.5 s |
| E5 | Bridge K1 aux (simulated weld), try reset | Reset refused |
| E6 | Unplug PC1 USB while driving on stands | MCU stops the motors |
| E7 | Base charger plugged in (if the base reports it) | Drive refused |
| E8 | 2 h run in the sun, E‑box closed | Inside < 50 °C |

**Have the safety circuit (E‑02) and the risk assessment checked by a qualified
person (ISO 13849) before anyone works next to the robot.**
