gelimorto2/binbot/cad/out/E-02_safety_circuit.pdf

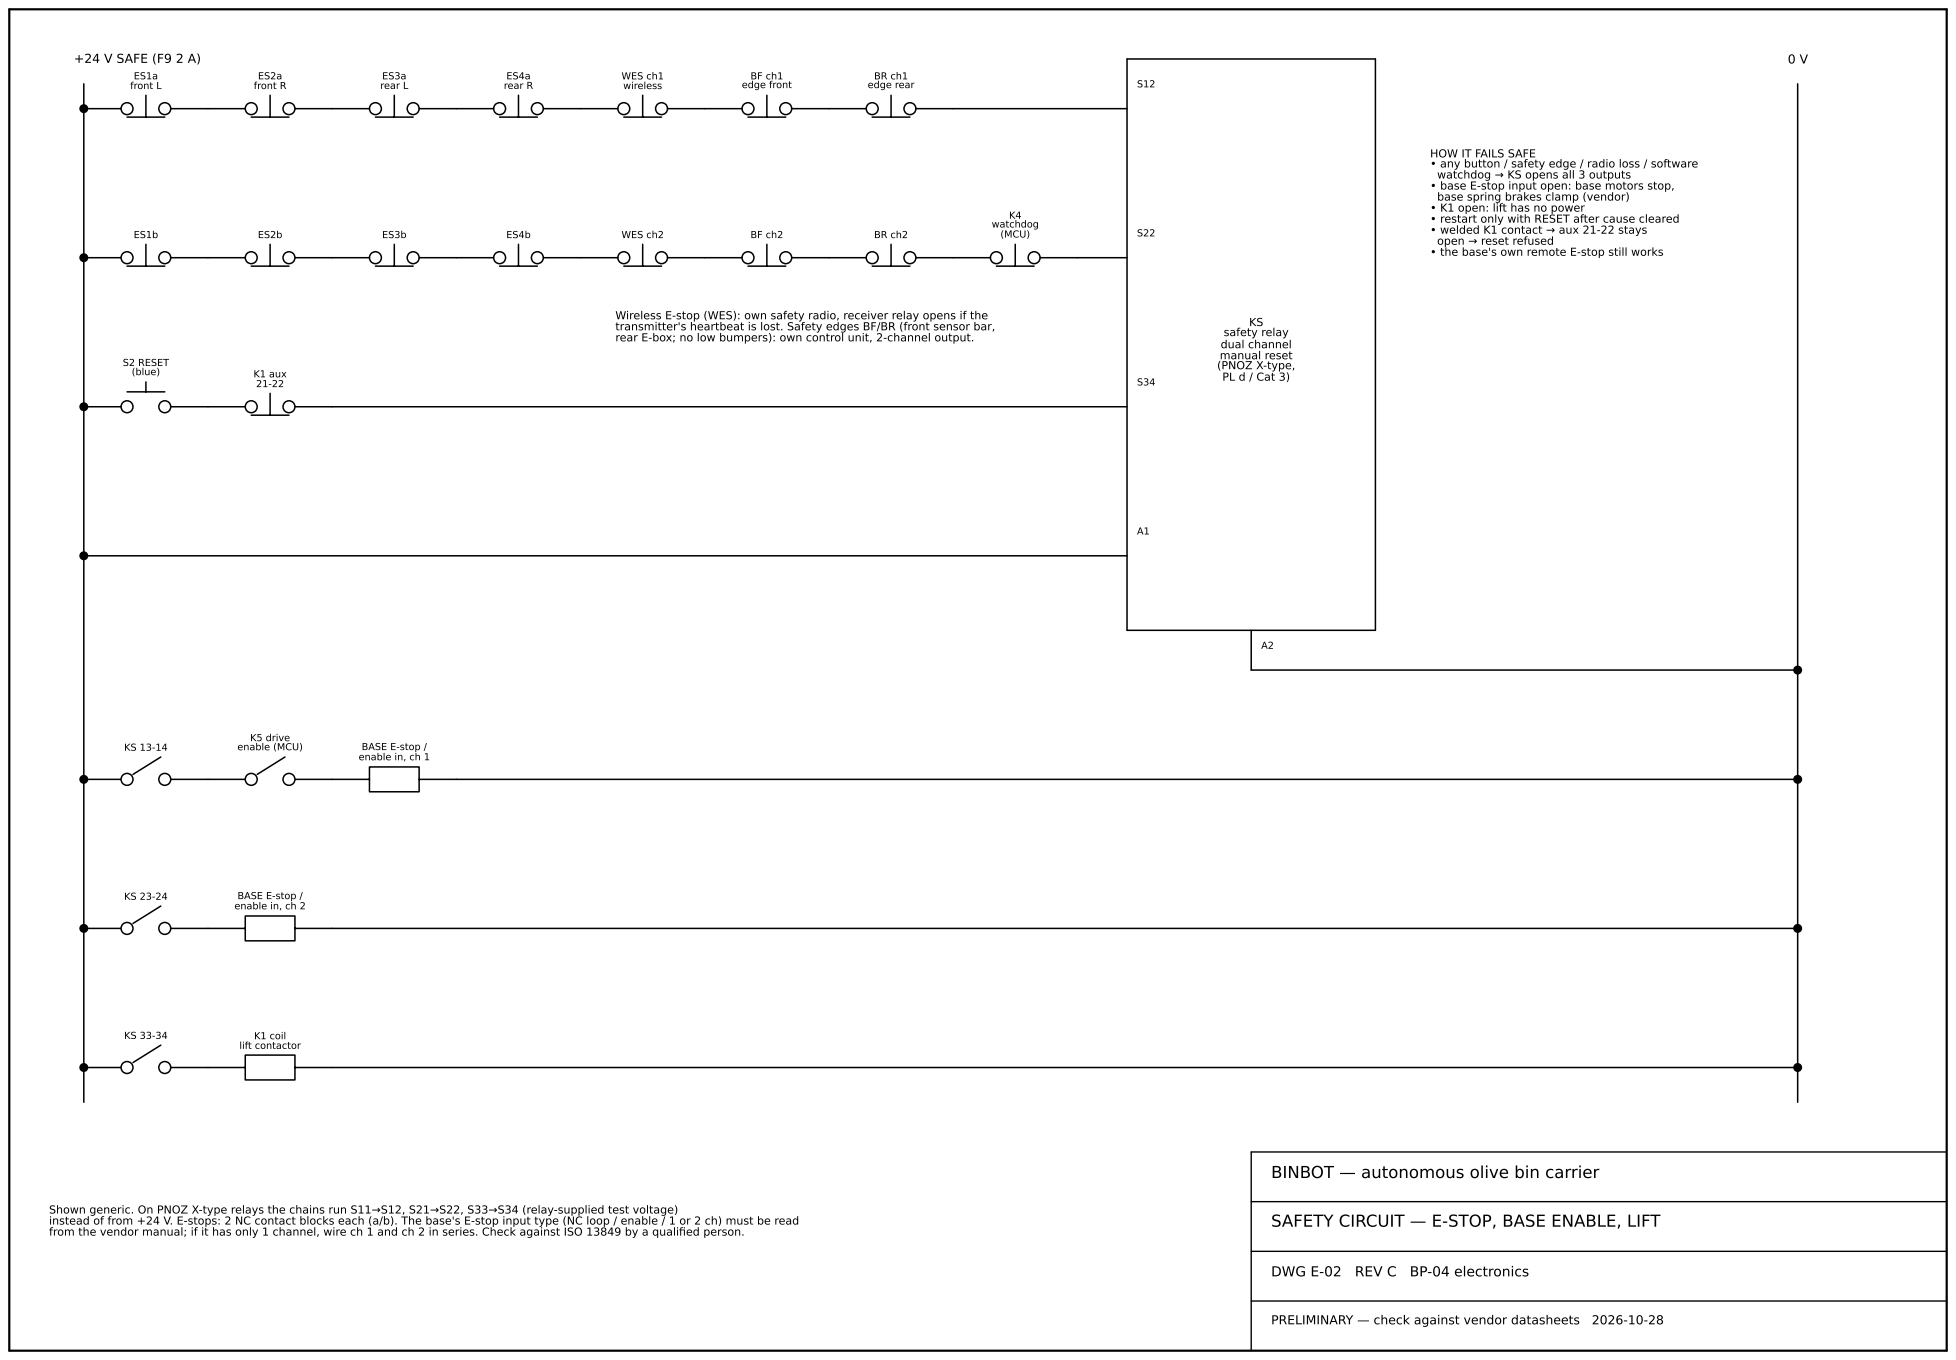
[picture p25: page 1]
+24 V SAFE (F9 2 A); KS safety relay dual channel manual reset (PNOZ X-type, PL d / Cat 3); ES1a front L; ES2a front R; ES3a rear L; ES4a rear R; WES ch1 wireless; BF ch1 edge front; edge rear; WES ch2; K4 watchdog; (MCU); S2 RESET; (blue); K1 aux; K5 drive; enable (MCU); BASE E-stop /; K1 coil; lift contactor

HOW IT FAILS SAFE
• any button / safety edge / radio loss / software
watchdog → KS opens all 3 outputs
• base E-stop input open: base motors stop,
base spring brakes clamp (vendor)
• K1 open: lift has no power
• restart only with RESET after cause cleared
• welded K1 contact → aux 21-22 stays
open → reset refused
• the base's own remote E-stop still works

Wireless E-stop (WES): own safety radio, receiver relay opens if the
transmitter's heartbeat is lost. Safety edges BF/BR (front sensor bar,
rear E-box; no low bumpers): own control unit, 2-channel output.

enable in, ch 1

enable in, ch 2

BINBOT — autonomous olive bin carrier

Shown generic. On PNOZ X-type relays the chains run S11→S12, S21→S22, S33→S34 (relay-supplied test voltage)
instead of from +24 V. E-stops: 2 NC contact blocks each (a/b). The base's E-stop input type (NC loop / enable / 1 or 2 ch) must be read
from the vendor manual; if it has only 1 channel, wire ch 1 and ch 2 in series. Check against ISO 13849 by a qualified person.

SAFETY CIRCUIT — E-STOP, BASE ENABLE, LIFT

DWG E-02 REV C BP-04 electronics

PRELIMINARY — check against vendor datasheets 2026-10-28
