gelimorto2/binbot/cad/out/E-03_control_block.pdf

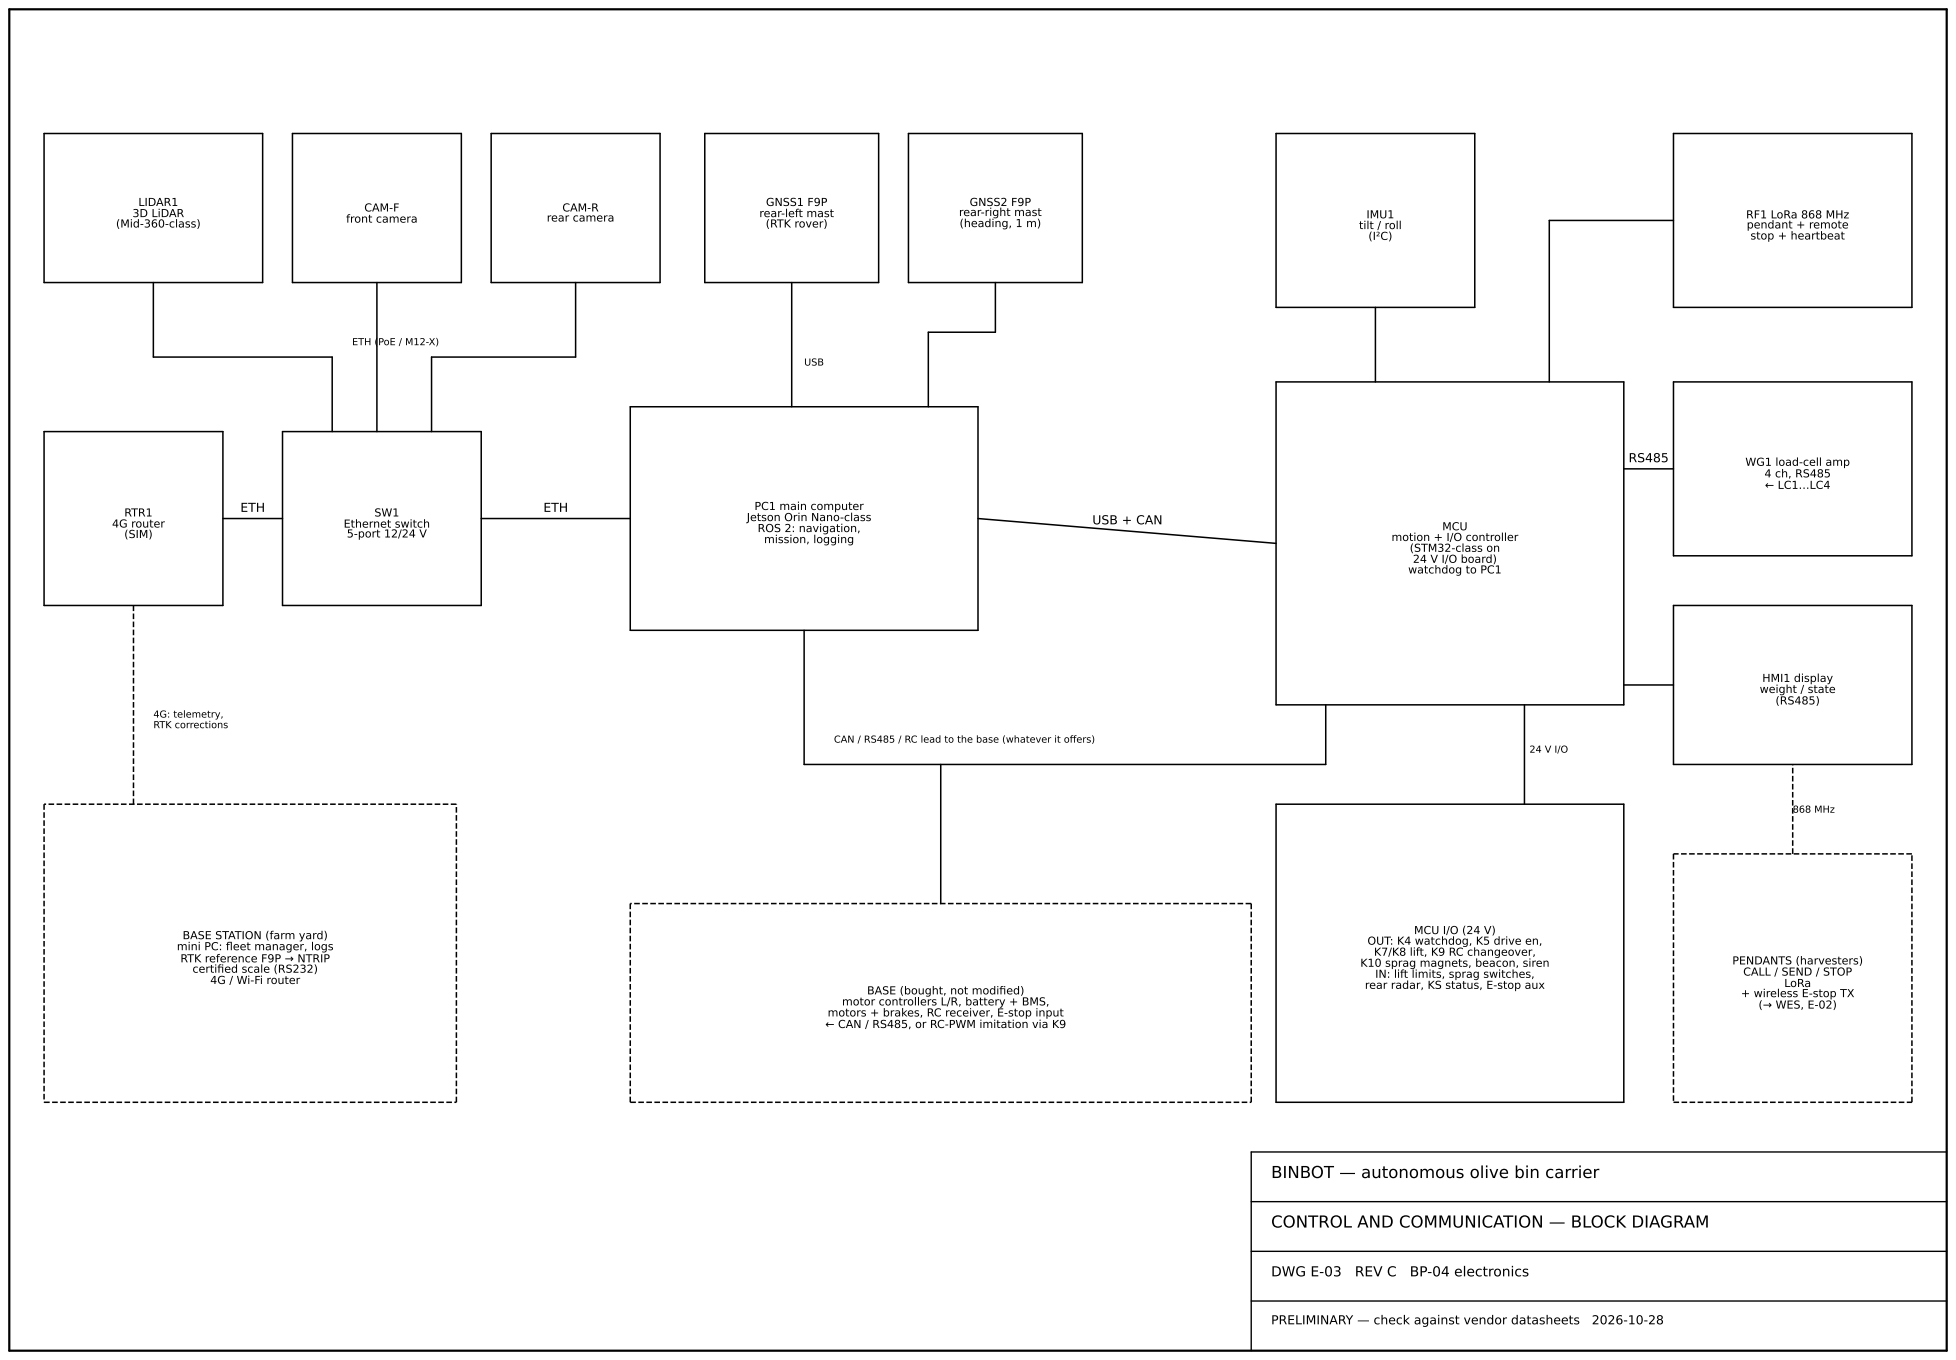
[picture p26: page 1]
SW1 Ethernet switch 5-port 12/24 V; LIDAR1 3D LiDAR (Mid-360-class); CAM-F front camera; CAM-R rear camera; RTR1 4G router (SIM); GNSS2 F9P rear-right mast (heading, 1 m); MCU motion + I/O controller (STM32-class on 24 V I/O board) watchdog to PC1; WG1 load-cell amp 4 ch, RS485 ← LC1…LC4; RF1 LoRa 868 MHz pendant + remote stop + heartbeat; HMI1 display weight / state (RS485); IMU1 tilt / roll (I²C); MCU I/O (24 V); LoRa; (→ WES, E-02); ETH; ETH (PoE / M12-X); USB; USB + CAN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

GNSS1 F9P
rear-left mast
(RTK rover)

PC1 main computer
Jetson Orin Nano-class
ROS 2: navigation,
mission, logging

CAN / RS485 / RC lead to the base (whatever it offers)

BASE STATION (farm yard)
mini PC: fleet manager, logs
RTK reference F9P → NTRIP
certified scale (RS232)
4G / Wi-Fi router

OUT: K4 watchdog, K5 drive en,
K7/K8 lift, K9 RC changeover,
K10 sprag magnets, beacon, siren
IN: lift limits, sprag switches,
rear radar, KS status, E-stop aux

PENDANTS (harvesters)
CALL / SEND / STOP

BASE (bought, not modified)
motor controllers L/R, battery + BMS,
motors + brakes, RC receiver, E-stop input
← CAN / RS485, or RC-PWM imitation via K9

+ wireless E-stop TX

BINBOT — autonomous olive bin carrier

CONTROL AND COMMUNICATION — BLOCK DIAGRAM

DWG E-03 REV C BP-04 electronics

PRELIMINARY — check against vendor datasheets 2026-10-28
