gelimorto2/binbot/cad/out/DWG-001_general_arrangement.pdf

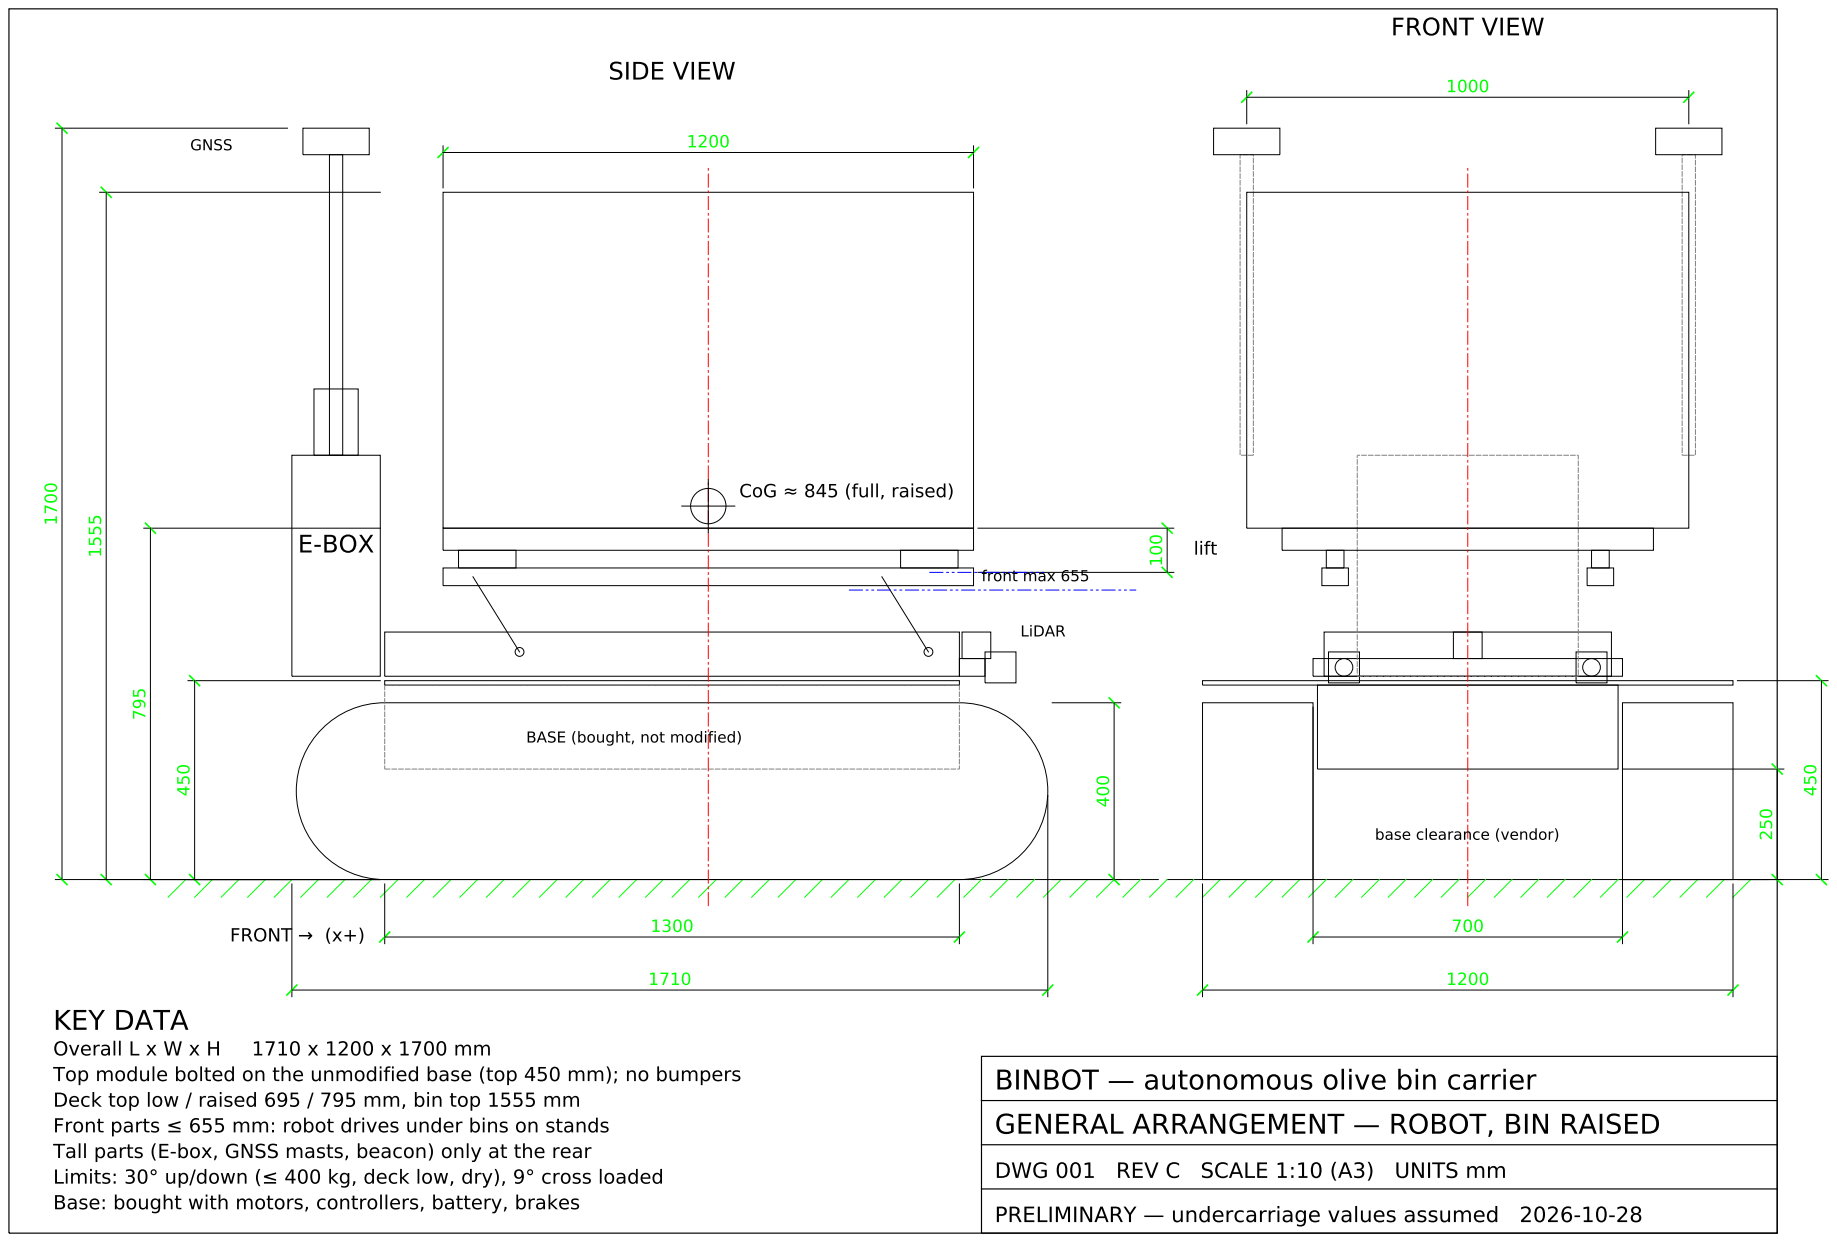
[picture p27: page 1]
