gelimorto2/binbot/cad/out/DWG-002_upper_frame_weldment.pdf

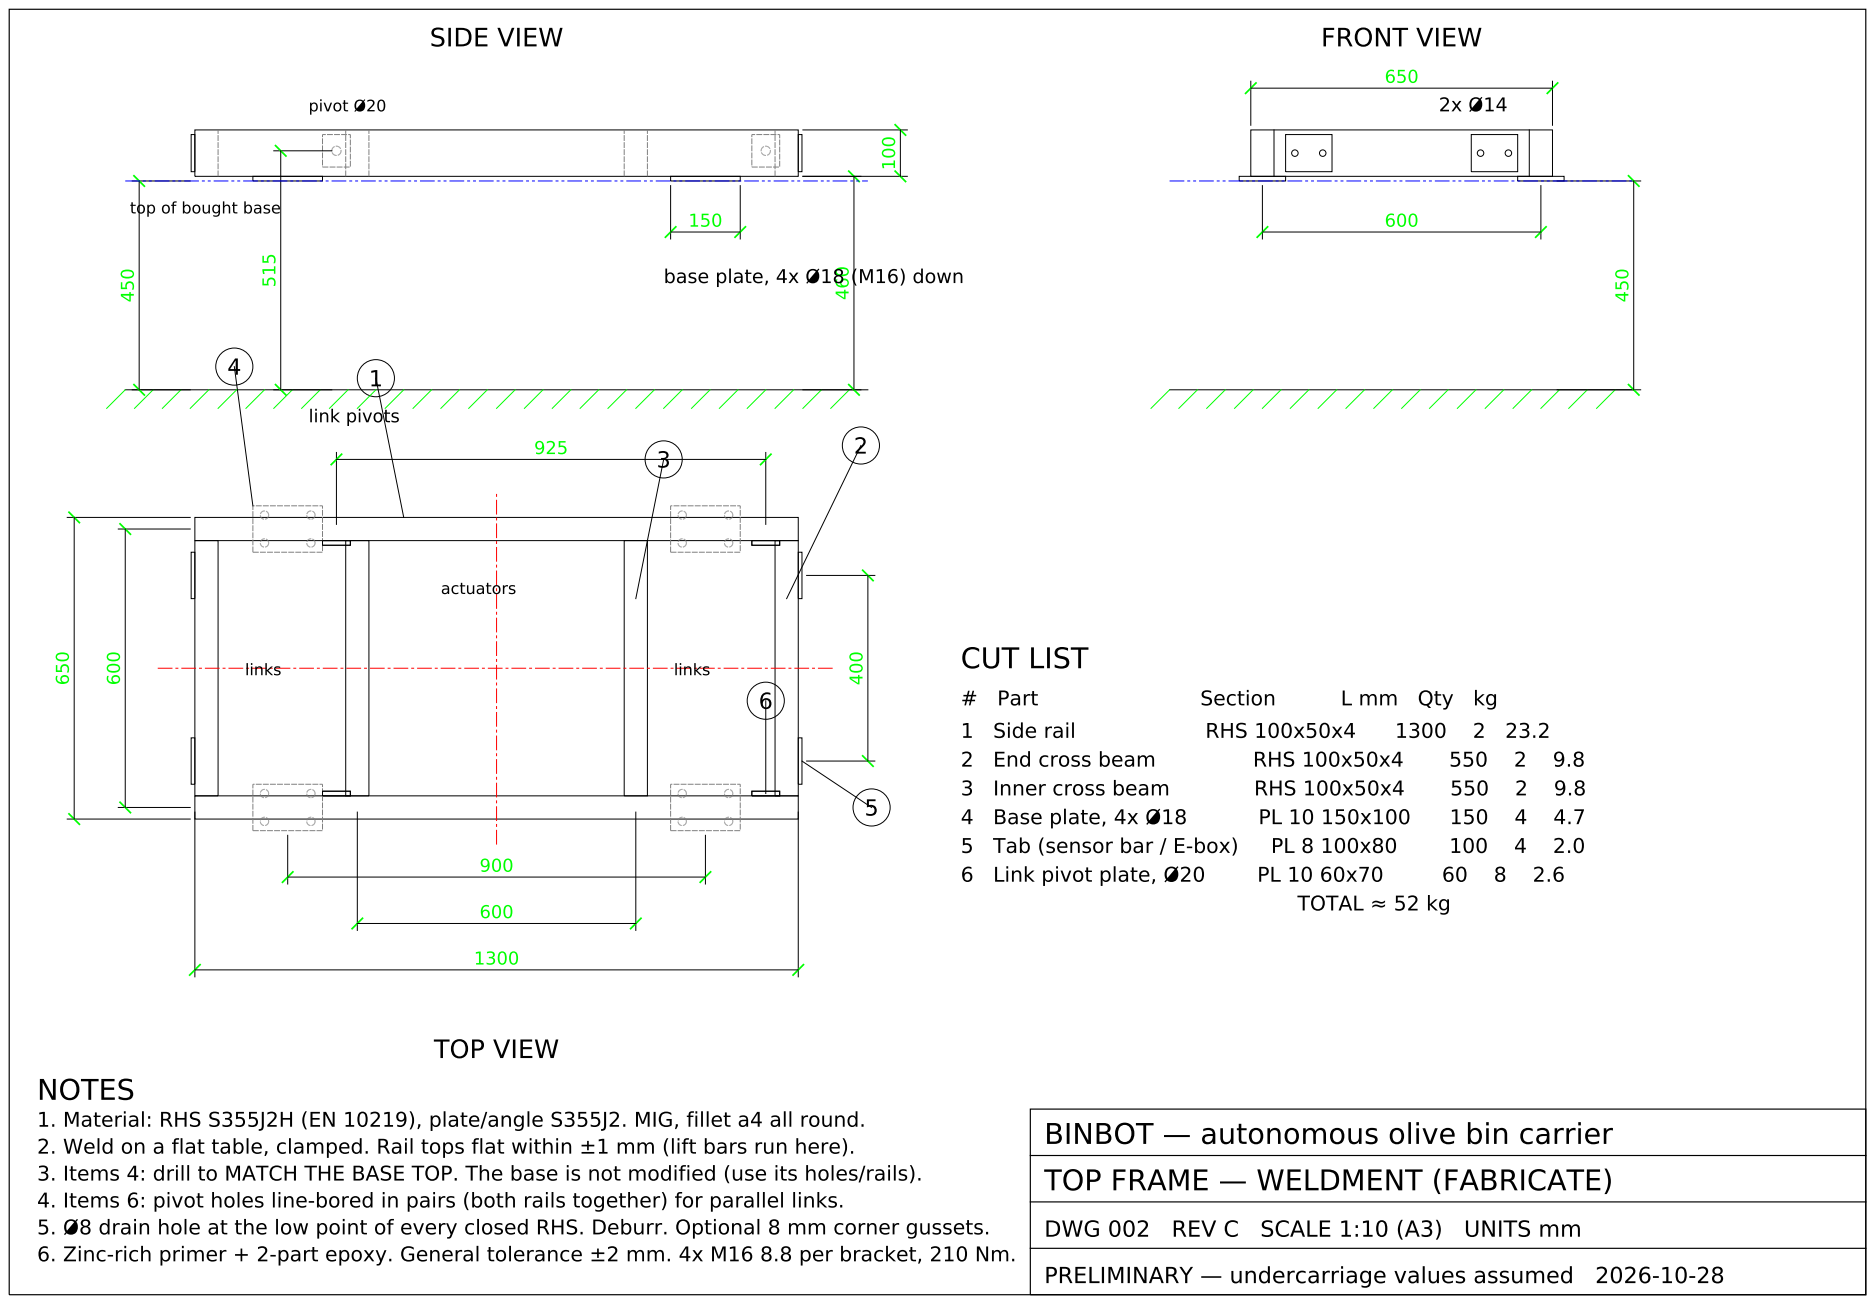
[picture p28: page 1]
