gelimorto2/binbot/cad/out/DWG-003_bin_stand.pdf

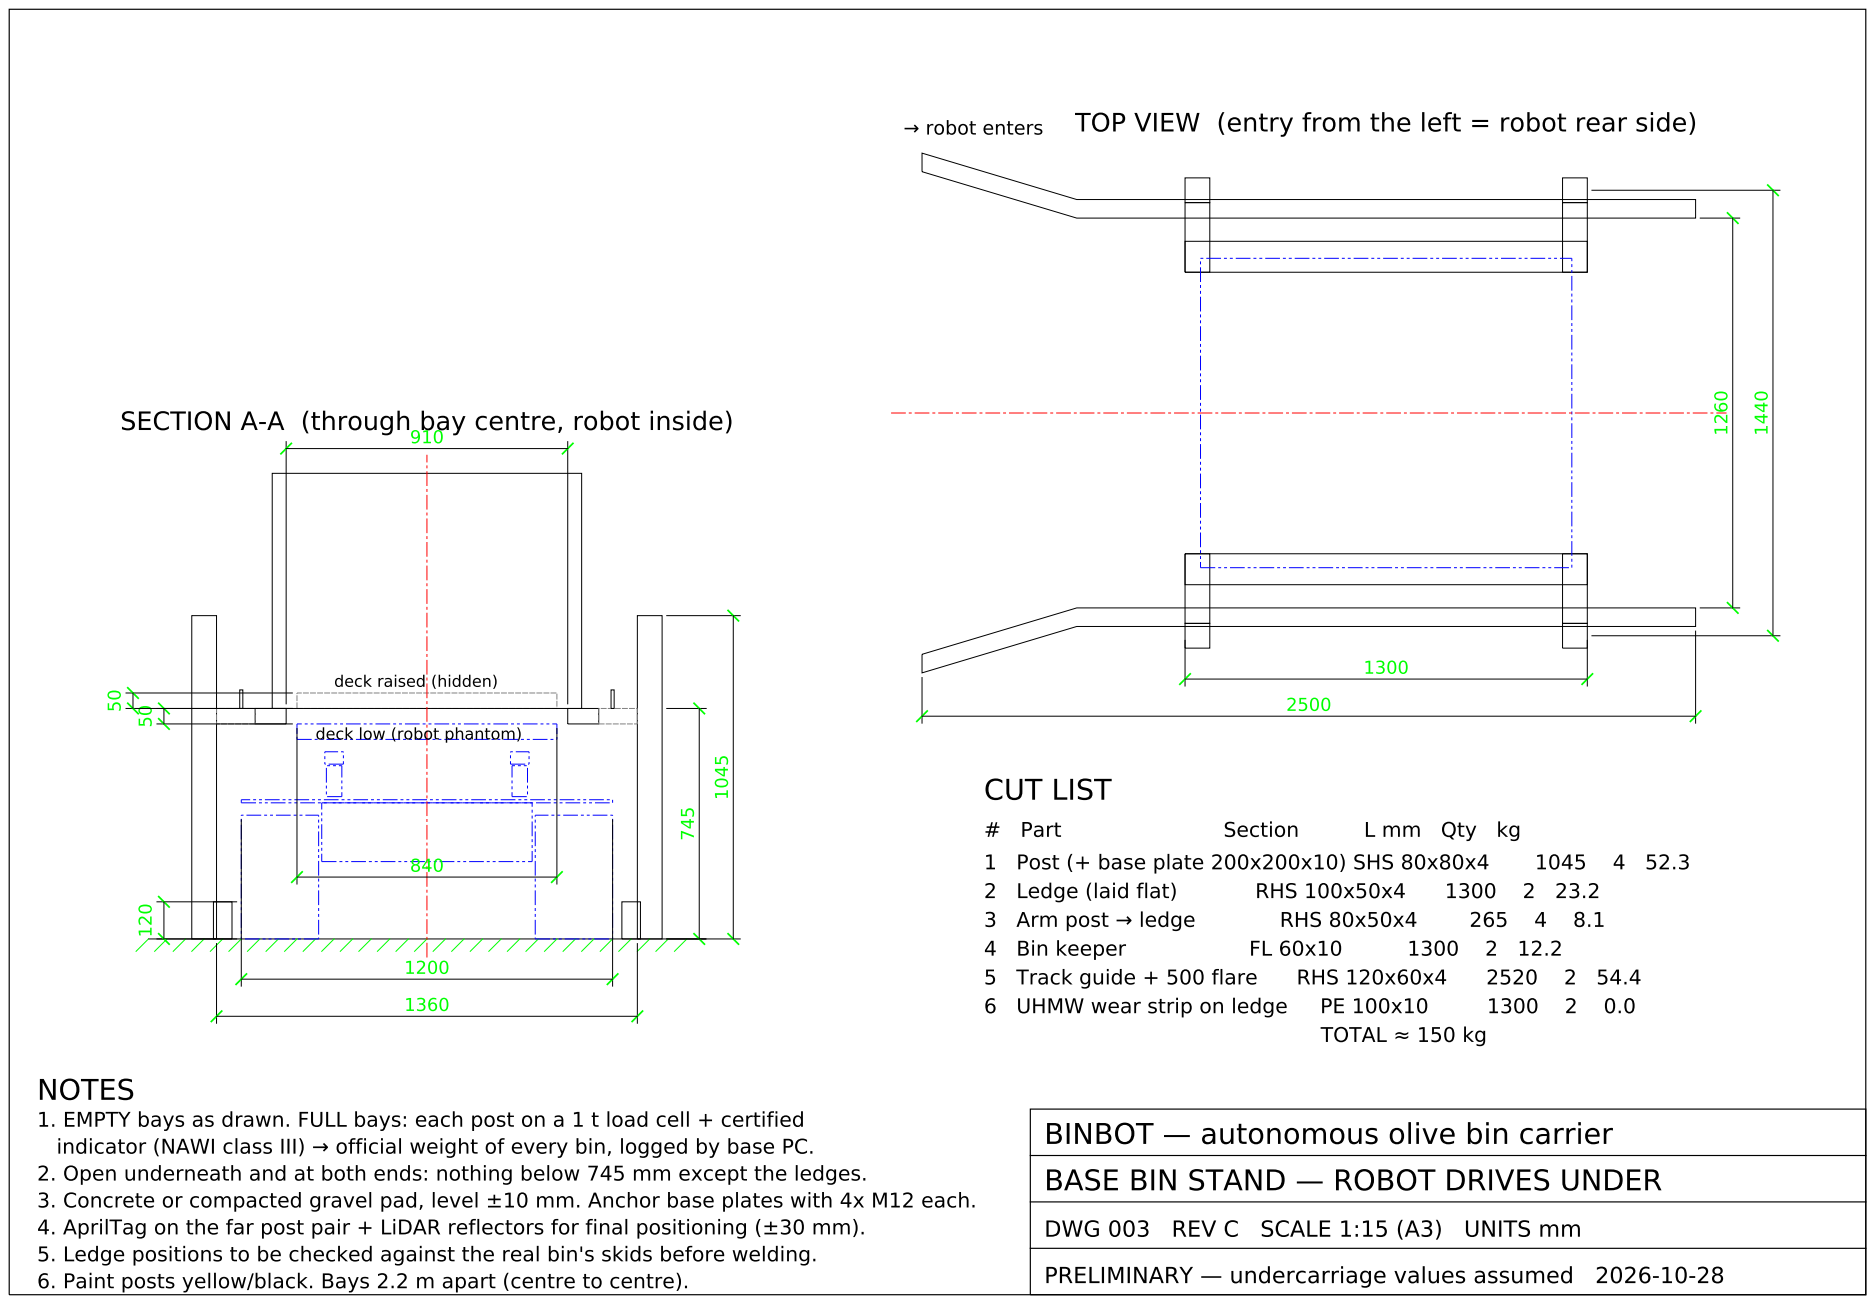
[picture p29: page 1]
