gelimorto2/binbot/(commit log)

2026-10-28 Add system wireframe: subsystems, operating cycle, safety concept
    Claude-Session: https://claude.ai/code/session_01YSPxXroGnq3Pio3taNTpiA
2026-10-28 Wireframe v0.2: farmer's answers, 500 kg/25° specs, budget plan
    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
2026-10-28 Wireframe: make automatic navigation a core requirement in budget plan
    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
2026-10-28 Add BP-01 chassis & drivetrain blueprint; record remaining answers
    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
2026-10-28 BP-01 v0.2: switch to bought 1.2 m electric track undercarriage
    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
2026-10-28 Add parametric CAD: 3D chassis model, GA and upper-frame fabrication drawings
    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
    [DWG-001_general_arrangement.dxf, DWG-002_upper_frame_weldment.dxf, chassis_assembly.step, chassis_assembly.stl, upper_frame.step, upper_frame.stl]
2026-10-28 Update budget with quoted €1,200 undercarriage
    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
2026-10-28 Add BP-04 electronics: power, safety and control schematics, E-box layout, components in 3D model
    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
    [DWG-001_general_arrangement.dxf, DWG-002_upper_frame_weldment.dxf, chassis_assembly.step, chassis_assembly.stl, upper_frame.step]
2026-10-28 Rev B: drive-under bin swap system, 350 mm clearance, low front, base stand drawing, swap video, white schematic backgrounds
    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
    [DWG-001_general_arrangement.dxf, DWG-002_upper_frame_weldment.dxf, DWG-003_bin_stand.dxf, bin_stand.step, bin_stand.stl, chassis_assembly.step, chassis_assembly.stl, swap_scene.step]
2026-10-28 Rev C: top module on an unmodified bought base; power, drive and E-stop through the base's own interfaces
    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
    [DWG-001_general_arrangement.dxf, DWG-002_upper_frame_weldment.dxf, DWG-003_bin_stand.dxf, bin_stand.step, bin_stand.stl, chassis_assembly.step, chassis_assembly.stl, swap_scene.step]
2026-10-28 Add DWG-004 stability limits drawing, road mode (deck lowered) and 8 kN lift actuators
    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
    [DWG-001_general_arrangement.dxf, DWG-002_upper_frame_weldment.dxf, DWG-003_bin_stand.dxf]
2026-10-28 Update stability for 30° slopes: 400 kg / deck-lowered rule, dry-only steep routes
    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
    [DWG-001_general_arrangement.dxf, DWG-002_upper_frame_weldment.dxf, DWG-003_bin_stand.dxf]
2026-10-28 Add anti-slide protection for 30° slopes: rear sprags, slide detection and response, DWG-005, BP-09a
    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
    [bin_stand.step, chassis_assembly.step, chassis_assembly.stl, swap_scene.step, upper_frame.step]
2026-10-28 Anti-spin: hold at both ends (front drag anchors + rear sprags), yaw detection, DWG-005 rev D
    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
    [bin_stand.step, chassis_assembly.step, chassis_assembly.stl, swap_scene.step, upper_frame.step]
